Hunajpu/trabajo_terminal/README.md

# trabajo_terminal
Repositorio para llevar control de versión del trabajo terminal
