Hunajpu/trabajo_terminal/PrimerreporteparcialTrabajoTerminal/portada.tex

\begin{titlepage}
 
\begin{center}
\newcommand{\HRule}{\rule{\linewidth}{0.5mm}}

\vspace*{1cm}
 
\textsc{\LARGE Unidad Profesional Interdisciplinaria en Ingeniería y Tecnologías Avanzadas}\\[1.5cm]
 
\textsc{\Large Primer Reporte Parcial}\\[0.5cm]

\HRule \\[0.4cm]
{ \huge \bfseries Eje Lineal para Robots Colaborativos Ligeros en ROS}\\[0.4cm]
 
\HRule \\[1.5cm]

\begin{minipage}{0.4\textwidth}
\begin{flushleft} \large
\emph{Presenta:}\\
Rodrigo Luna Reyes\\
\end{flushleft}
\end{minipage}
\begin{minipage}{0.5\textwidth}
\begin{flushright} \large
\emph{Asesores:} \\
Gaston Hugo Salazar Silva
\end{flushright}
\end{minipage}
 
\vfill
 
{\large \today}
 
\end{center}
 
\end{titlepage}
