Hunajpu/trabajo_terminal/PrimerreporteparcialTrabajoTerminal/1 Inicial/Antecedentes.tex

\section{Antecedentes}
\begin{center}
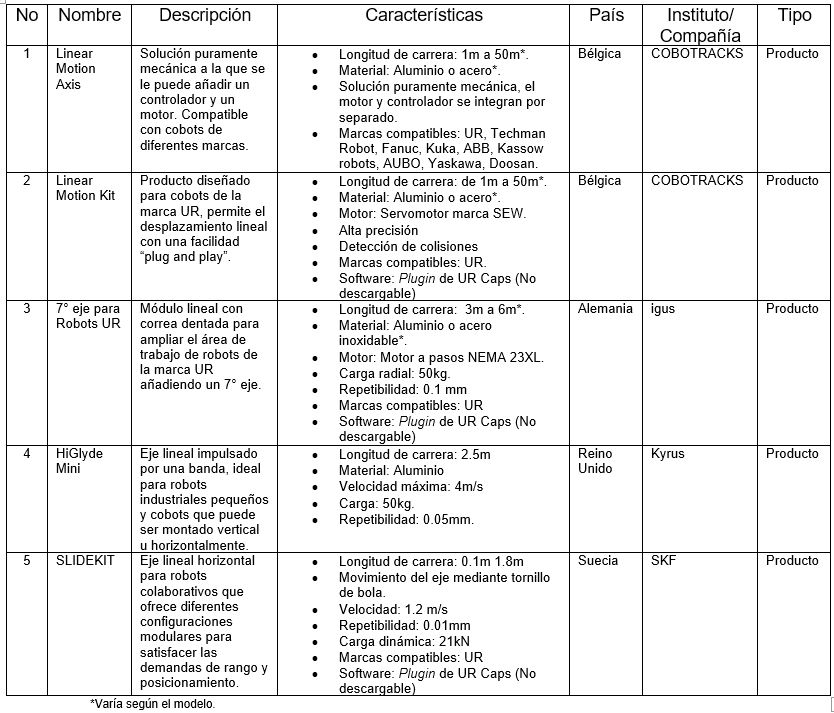
[picture p8: PrimerreporteparcialTrabajoTerminal/Tablas/tabla_antecedentes.JPG]
  
  \captionof{table}{Antecedentes}
  \label{fig:antecedentes}
\end{center}
