Hunajpu/trabajo_terminal/PrimerreporteparcialTrabajoTerminal/1 Inicial/Objetivos.tex

\section{Objetivos}
Objetivo General
\begin{itemize}
    \item Elaborar un eje lineal para diferentes modelos de robots colaborativos ligeros controlado en el entorno de código abierto “ROS”.
\end{itemize}
\begin{enumerate}
    \item Objetivos Específicos para Trabajo Terminal 1
\begin{itemize}
    \item Diseñar un mecanismo de movimiento lineal capaz de desplazar 20kg de carga.
    \item Diseñar un sistema de control para el mecanismo de movimiento.
    \item Diseñar una base compatible con diferentes modelos de cobots.
\end{itemize}

\item Objetivos Específicos para Trabajo Terminal 2
\begin{itemize}
    \item Construir el mecanismo de movimiento lineal.
    \item Construir base adaptable.
    \item Implementar el sistema de control.
    \item Codificar un paquete de ROS para la interfaz entre el eje lineal y el entorno de programación.
    \item Validar mediante simulaciones la sincronización del eje lineal y el cobot durante el seguimiento de trayectorias.
\end{itemize}

\end{enumerate}
