Hunajpu/trabajo_terminal/Cronograma/Overview.html

Project Overview

The project is structured into 3 phases.

Specification

Testing

Original Project Plan

No.

Actividad

Responsable

Inicio

Termino

Días

Jan 2022

Feb 2022

Mar 2022

Apr 2022

May 2022

Jun 2022

Jul 2022

Aug 2022

Sep 2022

Oct 2022

24

31

07

14

21

28

07

14

21

28

04

11

18

25

02

09

16

23

30

06

13

20

27

04

11

18

25

01

08

15

22

29

05

12

19

26

03

10

17

Start: 31-01-2022 End: 14-10-2022

Resources:

Precursors:

Followers:

Start: 31-01-2022 End: 06-05-2022

Resources:

Precursors:

Followers:

Construcción de subsistemas (EjeCobots.build) ]->[ 16-05-2022, Construcción de la estructura (EjeCobots.build.b_struct) ]->[ 01-08-2022, Construcción del mecanismo de movimiento (EjeCobots.build.b_mech) ]->[ 11-07-2022, Construcción de sistemas electrónicos (EjeCobots.build.b_electro) ]->[ 15-08-2022, Programación de paquete de ROS (EjeCobots.build.dev_ros) ]->[ 16-05-2022, Modelo 3D del proyecto (EjeCobots.check.sim) ]->[ 05-09-2022, Informe de TT1 (EjeCobots.doc1) ]->[ 09-05-2022

Start: 31-01-2022 End: 25-02-2022

Resources:

Rodrigo Luna Reyes (inge)

Precursors:

Followers:

Selección de motor y controladores (EjeCobots.design.motor) ]->[ 28-02-2022

Start: 28-02-2022 End: 01-03-2022

Resources:

Rodrigo Luna Reyes (inge)

Precursors:

Diseño del mecanismo de movimiento (EjeCobots.design.mech) ]->[ 25-02-2022

Followers:

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

Followers:

Start: 03-10-2022 End: 07-10-2022

Resources:

Rodrigo Luna Reyes (inge)

Precursors:

Construcción del mecanismo de movimiento (EjeCobots.build.b_mech) ]->[ 29-07-2022, Construcción de sistemas electrónicos (EjeCobots.build.b_electro) ]->[ 02-09-2022, Programación de paquete de ROS (EjeCobots.build.dev_ros) ]->[ 08-07-2022

Followers:

Start: 10-10-2022 End: 14-10-2022

Resources:

Rodrigo Luna Reyes (inge)

Precursors:

Informe de TT1 (EjeCobots.doc1) ]->[ 13-05-2022

Followers:

1

Icon | Eje lineal para Robots Colavorativos en ROS

ID: EjeCobots

Rodrigo Luna Reyes

31-01-2022

14-10-2022

185.0

1.1

| Icon | Diseño detallado

ID: EjeCobots.design

Rodrigo Luna Reyes

31-01-2022

06-05-2022

70.0

1.1.1

| Icon | Diseño del mecanismo de movimiento

ID: EjeCobots.design.mech

Rodrigo Luna Reyes

31-01-2022

25-02-2022

20.0

1.1.2

| Icon | Selección de motor y controladores

ID: EjeCobots.design.motor

Rodrigo Luna Reyes

28-02-2022

01-03-2022

2.0

1.1.3

| Icon | Diseño de la estructrua

ID: EjeCobots.design.estructura

Rodrigo Luna Reyes

02-03-2022

22-03-2022

15.0

1.1.4

| Icon | Diseño de electrónica para accionamiento mecánico

ID: EjeCobots.design.mech_electro

Rodrigo Luna Reyes

23-03-2022

07-04-2022

12.0

1.1.5

| Icon | Diseño de electrónica para gestión de información

ID: EjeCobots.design.info_electro

Rodrigo Luna Reyes

08-04-2022

25-04-2022

12.0

1.1.6

| Icon | Selección y diseño de la fuente de alimentación

ID: EjeCobots.design.psu

Rodrigo Luna Reyes

26-04-2022

27-04-2022

2.0

1.1.7

| Icon | Diseño de software

ID: EjeCobots.design.soft

Rodrigo Luna Reyes

28-04-2022

06-05-2022

7.0

1.5

| Icon | Informe de TT1

ID: EjeCobots.doc1

Rodrigo Luna Reyes

09-05-2022

13-05-2022

5.0

1.2

| Icon | Construcción de subsistemas

ID: EjeCobots.build

Rodrigo Luna Reyes

16-05-2022

02-09-2022

80.0

1.2.4

| Icon | Programación de paquete de ROS

ID: EjeCobots.build.dev_ros

Rodrigo Luna Reyes

16-05-2022

08-07-2022

40.0

1.2.2

| Icon | Construcción del mecanismo de movimiento

ID: EjeCobots.build.b_mech

Rodrigo Luna Reyes

11-07-2022

29-07-2022

15.0

1.2.1

| Icon | Construcción de la estructura

ID: EjeCobots.build.b_struct

Rodrigo Luna Reyes

01-08-2022

12-08-2022

10.0

1.2.3

| Icon | Construcción de sistemas electrónicos

ID: EjeCobots.build.b_electro

Rodrigo Luna Reyes

15-08-2022

02-09-2022

15.0

1.3

| Icon | Implementación de subsistemas

ID: EjeCobots.check

Rodrigo Luna Reyes

05-09-2022

23-09-2022

15.0

1.3.2

| Icon | Modelo 3D del proyecto

ID: EjeCobots.check.sim

Rodrigo Luna Reyes

05-09-2022

16-09-2022

10.0

1.3.1

| Icon | Ensamble de subsistemas

ID: EjeCobots.check.ensam

Rodrigo Luna Reyes

19-09-2022

23-09-2022

5.0

1.4

| Icon | Pruebas de funcionamiento

ID: EjeCobots.test

Rodrigo Luna Reyes

26-09-2022

07-10-2022

10.0

1.4.1

| Icon | Prueba de movimiento

ID: EjeCobots.test.test_mov

Rodrigo Luna Reyes

26-09-2022

30-09-2022

5.0

1.4.2

| Icon | Prueba de ROS

ID: EjeCobots.test.test_ros

Rodrigo Luna Reyes

03-10-2022

07-10-2022

5.0

1.6

| Icon | Informe de TT2

ID: EjeCobots.doc2

Rodrigo Luna Reyes

10-10-2022

14-10-2022

5.0

| | Container Task | | | Normal Task | | | Milestone
| | Off-duty period

## Staffing

All project phases are properly staffed. See ResourceGraph for detailed resource allocations.

## Current Status

The project started off with a delay of 4 days. This slightly affected the original schedule. See Deliveries for the impact on the delivery dates.

Project: Eje lineal para Cobots Version: 1.0 - Created on 2021-10-18 11:16:27 with TaskJuggler (http://www.taskjuggler.org) v3.7.1
