Hunajpu/trabajo_terminal/Base Cobots con barrenos indicados.odp

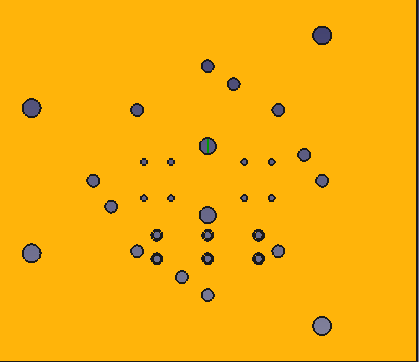
[picture p17: figure]

UR3

xArm

AUBO i3

Jaco

Bloque

Placa

Panda
