Hunajpu/trabajo_terminal/Piezas/mgn12-rail-500mm/123.PNG

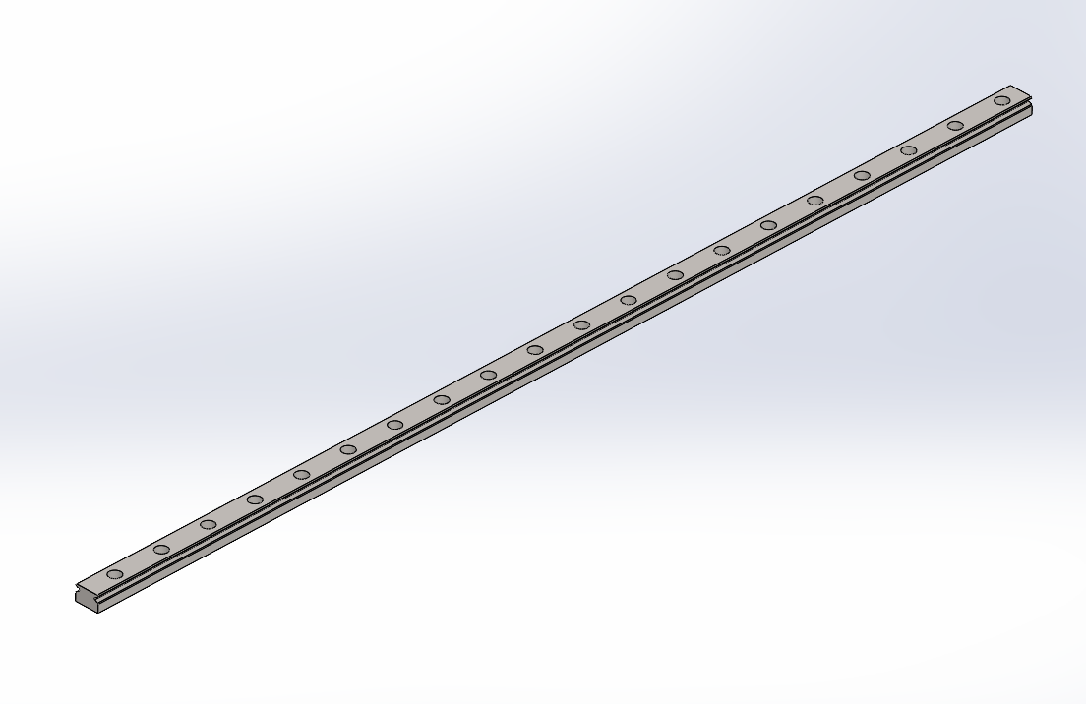
Piezas/mgn12-rail-500mm/123.PNG
