Hunajpu/trabajo_terminal/Piezas/mgn12c/MG12C.JPG

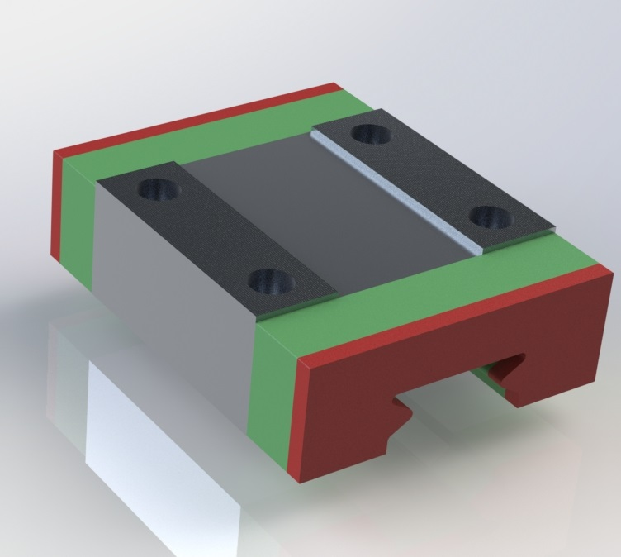
Piezas/mgn12c/MG12C.JPG
