Hunajpu/trabajo_terminal/Ensamble/Carro.FCStd

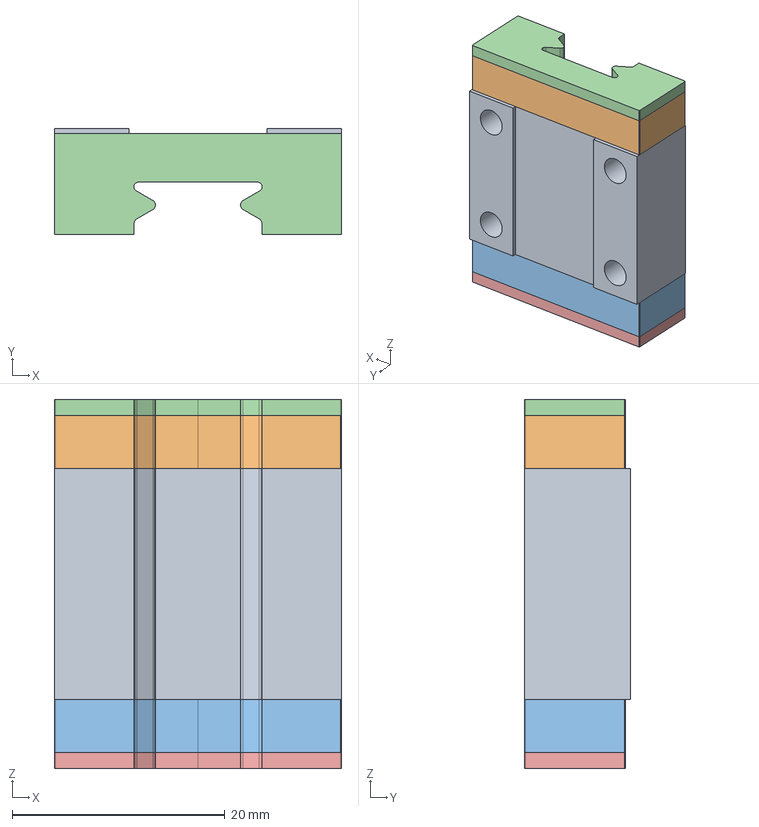
[picture p22: CAD file, 2022-05-12]
Ensamble/Carro.FCStd
27.0 x 10.0 x 34.7 mm
