Hunajpu/trabajo_terminal/Piezas/belt_clamp/TBCK-XL025.stp

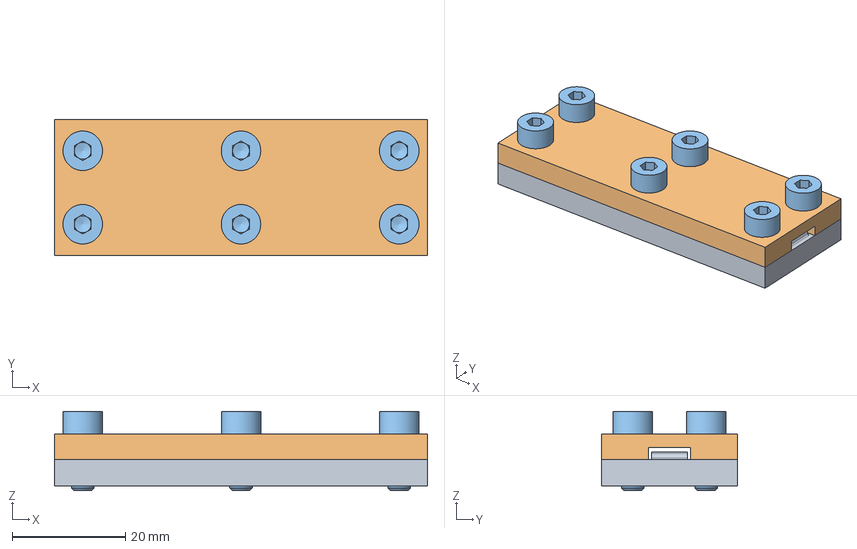
[picture p23: CAD file, 2022-05-12]
Piezas/belt_clamp/TBCK-XL025.stp
66.0 x 24.0 x 14.0 mm
_TBCKsupport_plate-XL025_r
_TBCKsupport_plate-XL025_support_plate
_CB4-10_1 x 6
