Hunajpu/trabajo_terminal/Piezas/guia_lineal/SRZL28-520.stp

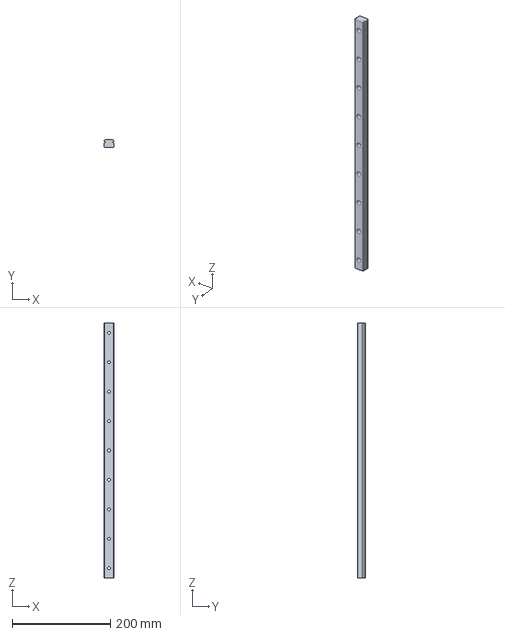
[picture p24: CAD file, 2022-03-16]
Piezas/guia_lineal/SRZL28-520.stp
20.0 x 15.5 x 520.0 mm
