Hunajpu/trabajo_terminal/Piezas/guia_lineal_set/SX2RZ28-520.stp

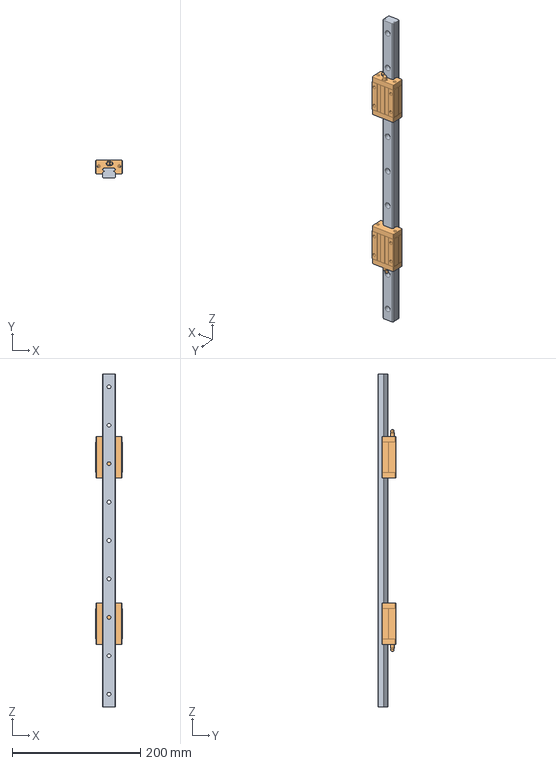
[picture p25: CAD file, 2022-03-16]
Piezas/guia_lineal_set/SX2RZ28-520.stp
42.0 x 28.0 x 520.0 mm
_SRZL28-520
_SXRB28 x 2
