Hunajpu/trabajo_terminal/Piezas/jaco.STL

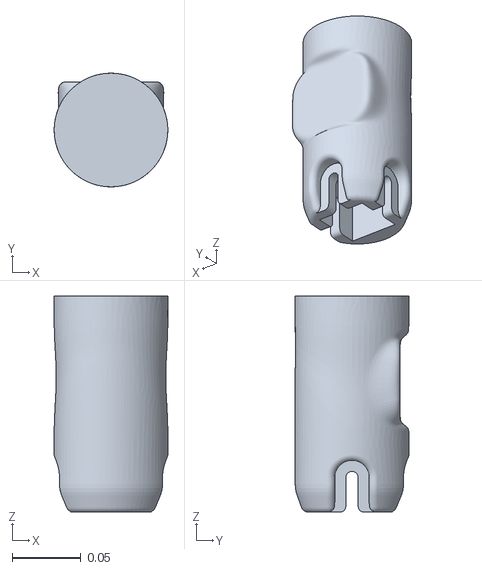
[picture p26: CAD file, 2022-03-16]
Piezas/jaco.STL
0.0825 x 0.0825 x 0.157
