Hunajpu/trabajo_terminal/Piezas/mgn12-rail-500mm/MGN12 Rail 500mm.step

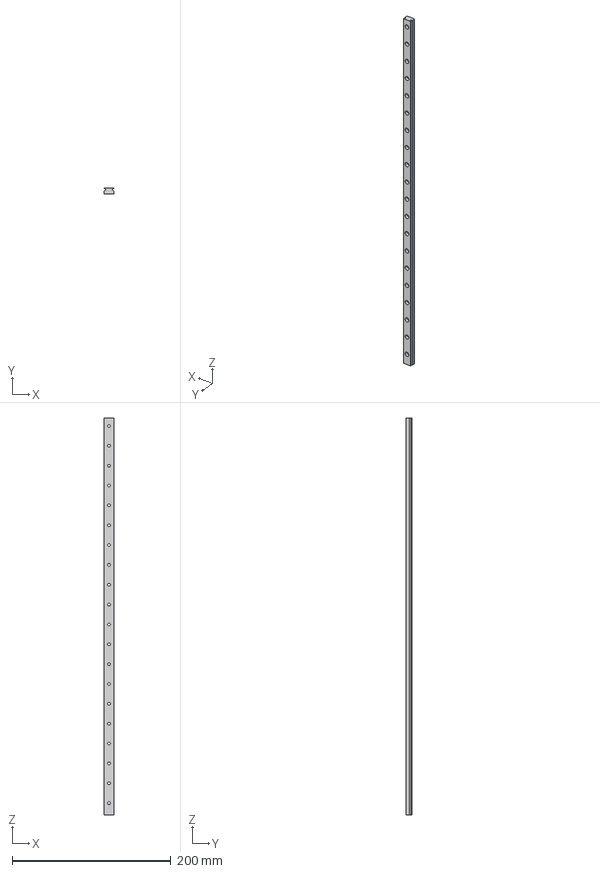
[picture p27: CAD file, 2022-03-16]
Piezas/mgn12-rail-500mm/MGN12 Rail 500mm.step
12.0 x 7.94 x 500.0 mm
