Hunajpu/trabajo_terminal/Piezas/Perfil 30x30/Aluminium30x30.step

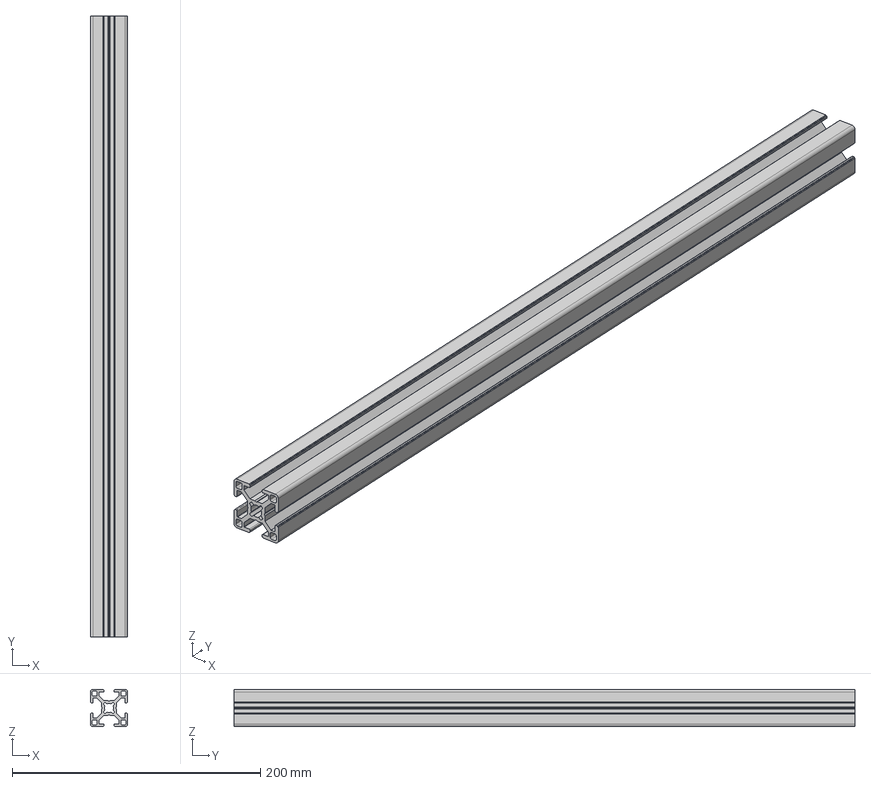
[picture p28: CAD file, 2022-05-12]
Piezas/Perfil 30x30/Aluminium30x30.step
30.0 x 500.0 x 30.0 mm
