Hunajpu/trabajo_terminal/Piezas/perfil aluminio 400/HFS8-4040-400.stp

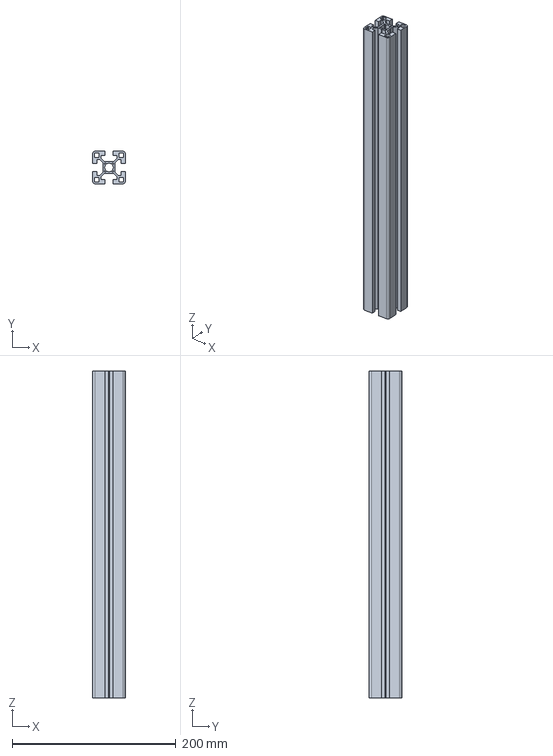
[picture p29: CAD file, 2022-03-16]
Piezas/perfil aluminio 400/HFS8-4040-400.stp
40.0 x 40.0 x 400.0 mm
