Hunajpu/trabajo_terminal/Piezas/polea/GPA15GT2090-A-H4.stp

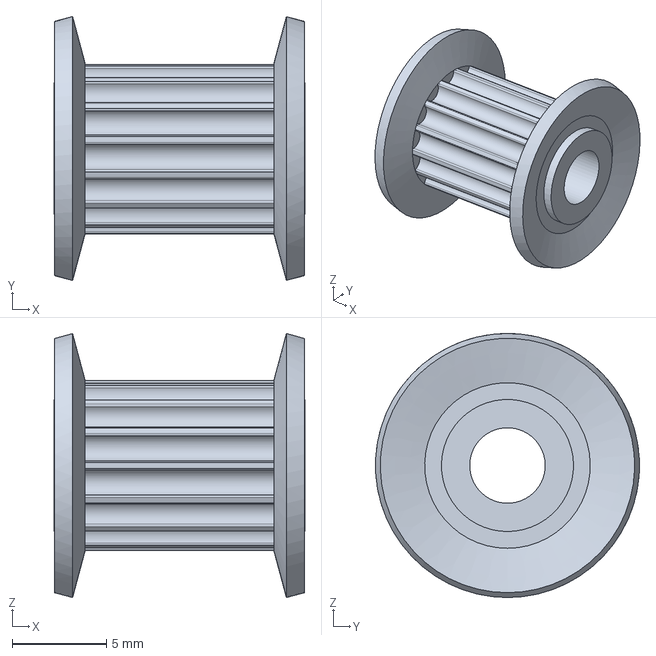
[picture p30: CAD file, 2022-03-16]
Piezas/polea/GPA15GT2090-A-H4.stp
13.3 x 14.0 x 14.0 mm
