Hunajpu/trabajo_terminal/Piezas/surpass-motor-3660-2220kv/Surpass Motor 3660 2200kv.STEP

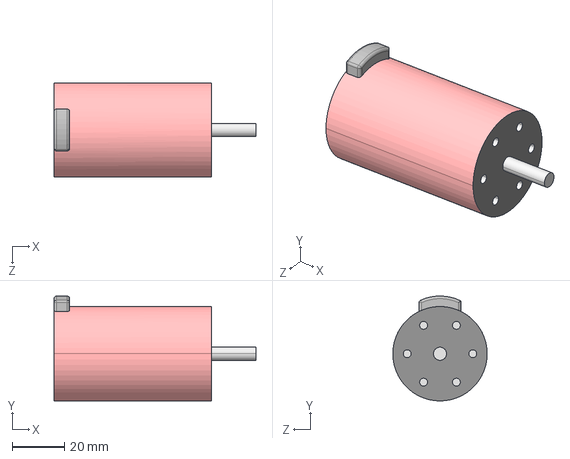
[picture p31: CAD file, 2022-03-16]
Piezas/surpass-motor-3660-2220kv/Surpass Motor 3660 2200kv.STEP
77.0 x 40.0 x 36.0 mm
