Hunajpu/trabajo_terminal/ros2_ur_driver/install/ur_description/share/ur_description/meshes/ur10/collision/wrist1.stl

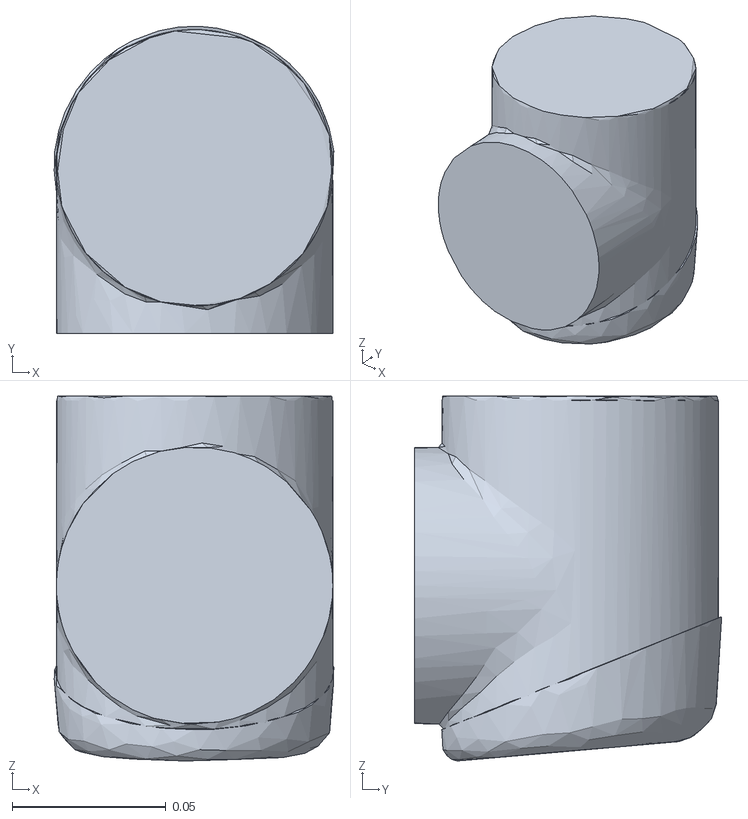
[picture p32: CAD file, 2022-03-16]
ros2_ur_driver/install/ur_description/share/ur_description/meshes/ur10/collision/wrist1.stl
0.091 x 0.1 x 0.119
