Hunajpu/trabajo_terminal/ros2_ur_driver/install/ur_description/share/ur_description/meshes/ur16e/collision/upperarm.stl

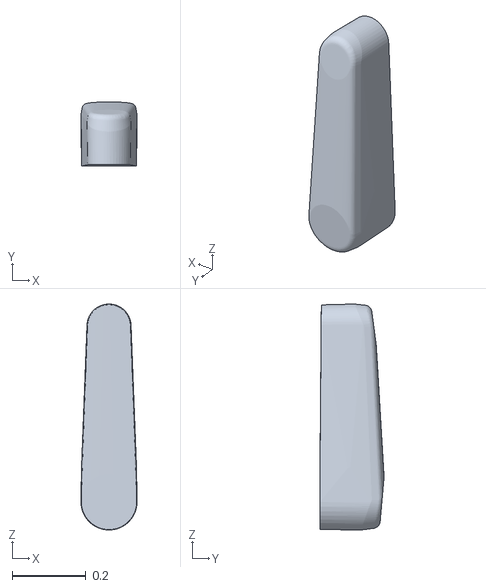
[picture p34: CAD file, 2022-03-16]
ros2_ur_driver/install/ur_description/share/ur_description/meshes/ur16e/collision/upperarm.stl
0.153 x 0.175 x 0.615
