Hunajpu/trabajo_terminal/ros2_ur_driver/install/ur_description/share/ur_description/meshes/ur3/collision/upperarm.stl

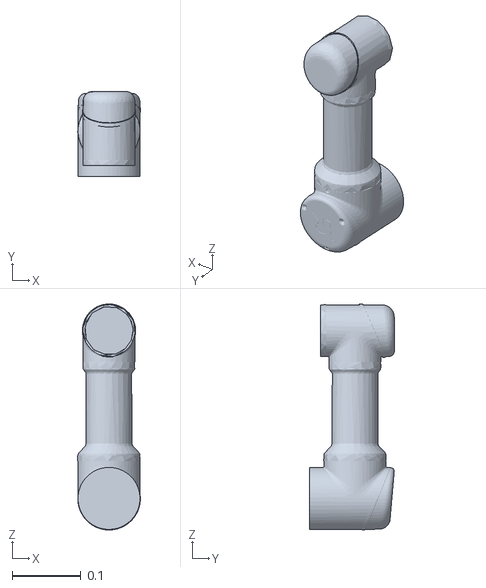
[picture p35: CAD file, 2022-03-16]
ros2_ur_driver/install/ur_description/share/ur_description/meshes/ur3/collision/upperarm.stl
0.0912 x 0.123 x 0.328
