Hunajpu/trabajo_terminal/ros2_ur_driver/install/ur_description/share/ur_description/meshes/ur3e/collision/forearm.stl

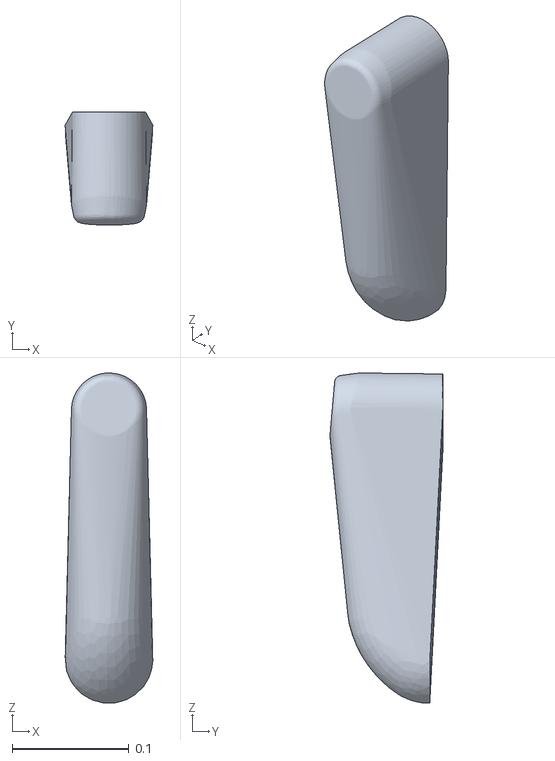
[picture p36: CAD file, 2022-03-16]
ros2_ur_driver/install/ur_description/share/ur_description/meshes/ur3e/collision/forearm.stl
0.0751 x 0.0969 x 0.283
