Hunajpu/trabajo_terminal/ros2_ur_driver/install/ur_description/share/ur_description/meshes/ur5/collision/upperarm.stl

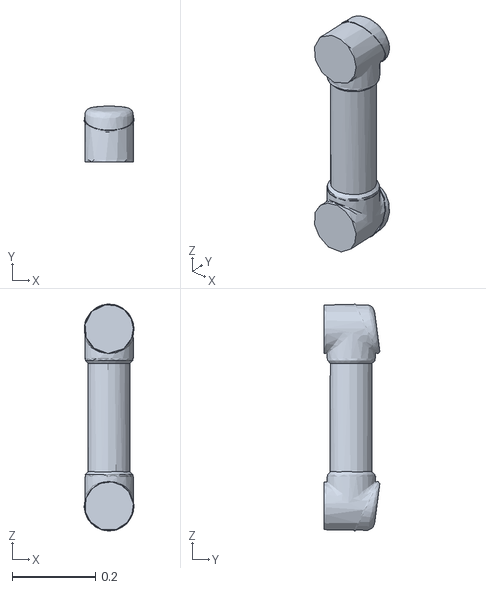
[picture p37: CAD file, 2022-03-16]
ros2_ur_driver/install/ur_description/share/ur_description/meshes/ur5/collision/upperarm.stl
0.119 x 0.134 x 0.545
