Hunajpu/trabajo_terminal/Piezas/base_link_xArm5.STL

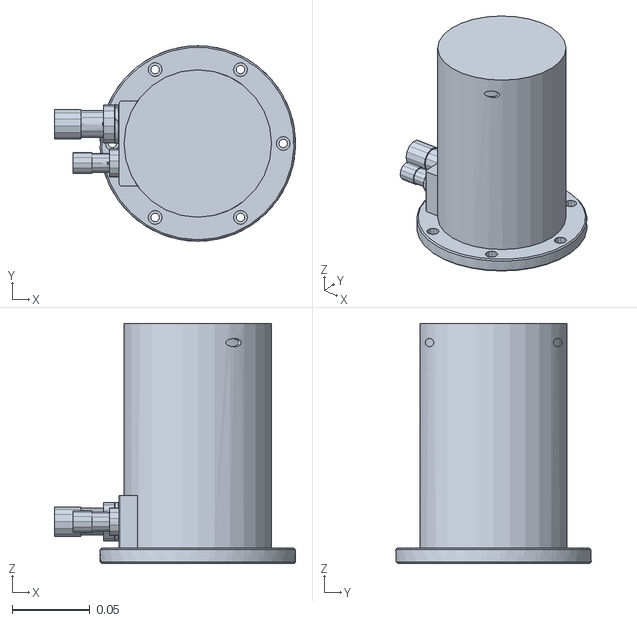
[picture p39: CAD file, 2022-03-16]
Piezas/base_link_xArm5.STL
0.155 x 0.126 x 0.155
