Hunajpu/trabajo_terminal/ros2_ur_driver/install/ur_description/share/ur_description/meshes/ur10/collision/forearm.stl

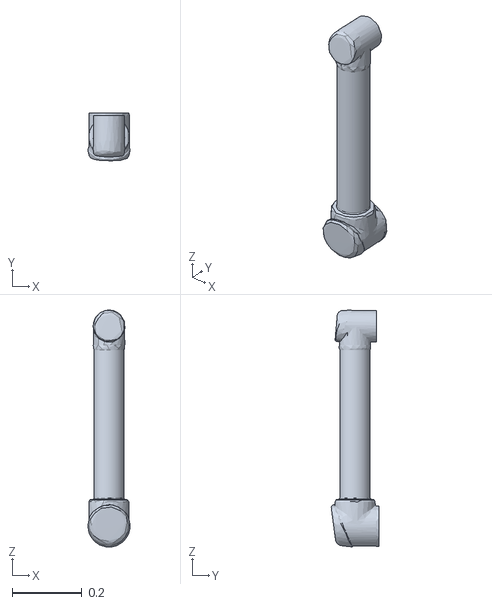
[picture p40: CAD file, 2022-03-16]
ros2_ur_driver/install/ur_description/share/ur_description/meshes/ur10/collision/forearm.stl
0.12 x 0.136 x 0.678
