Hunajpu/trabajo_terminal/ros2_ur_driver/install/ur_description/share/ur_description/meshes/ur10e/collision/wrist1.stl

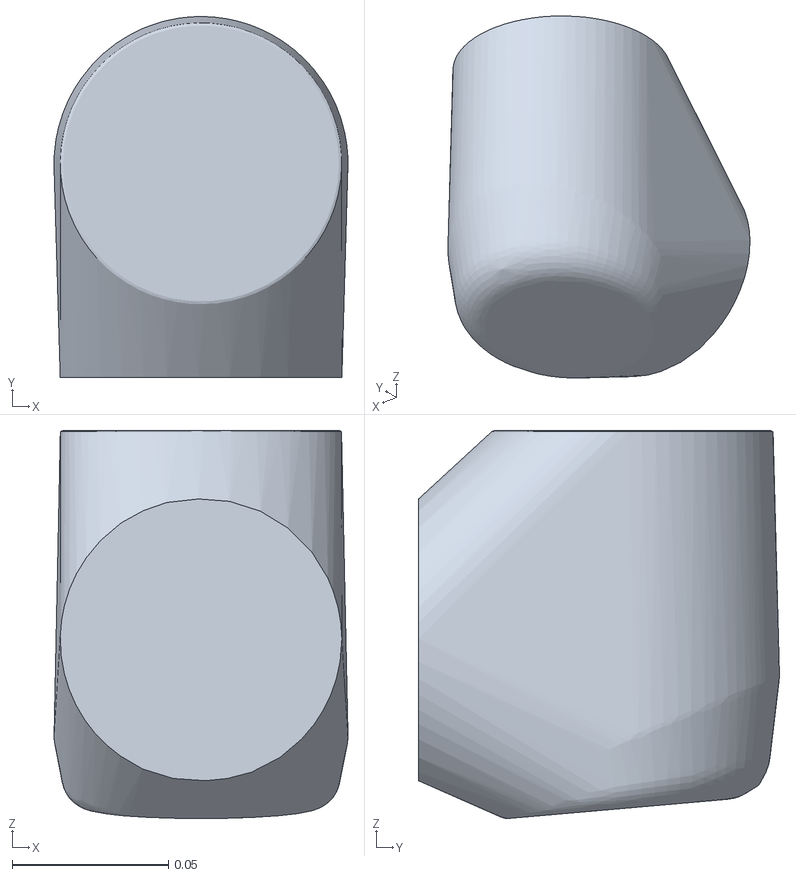
[picture p41: CAD file, 2022-03-16]
ros2_ur_driver/install/ur_description/share/ur_description/meshes/ur10e/collision/wrist1.stl
0.094 x 0.115 x 0.124
