Hunajpu/trabajo_terminal/ros2_ur_driver/install/ur_description/share/ur_description/meshes/ur3/collision/shoulder.stl

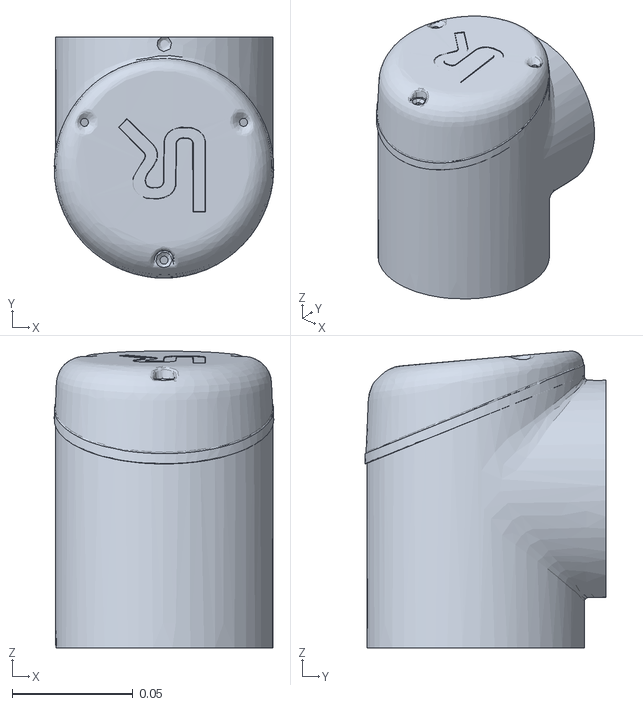
[picture p43: CAD file, 2022-03-16]
ros2_ur_driver/install/ur_description/share/ur_description/meshes/ur3/collision/shoulder.stl
0.0909 x 0.0999 x 0.123
