Hunajpu/trabajo_terminal/ros2_ur_driver/install/ur_description/share/ur_description/meshes/ur3e/collision/wrist3.stl

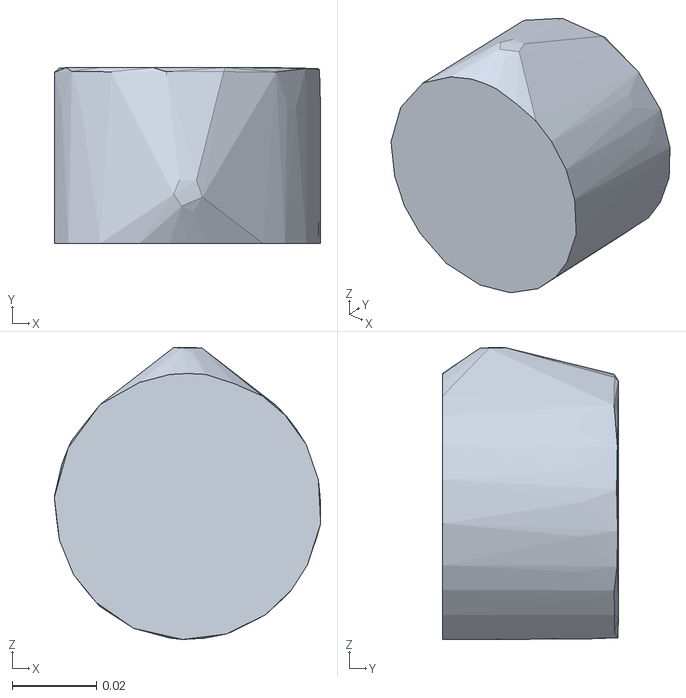
[picture p44: CAD file, 2022-03-16]
ros2_ur_driver/install/ur_description/share/ur_description/meshes/ur3e/collision/wrist3.stl
0.0632 x 0.0417 x 0.0692
