Hunajpu/trabajo_terminal/ros2_ur_driver/install/ur_description/share/ur_description/meshes/ur5/collision/wrist3.stl

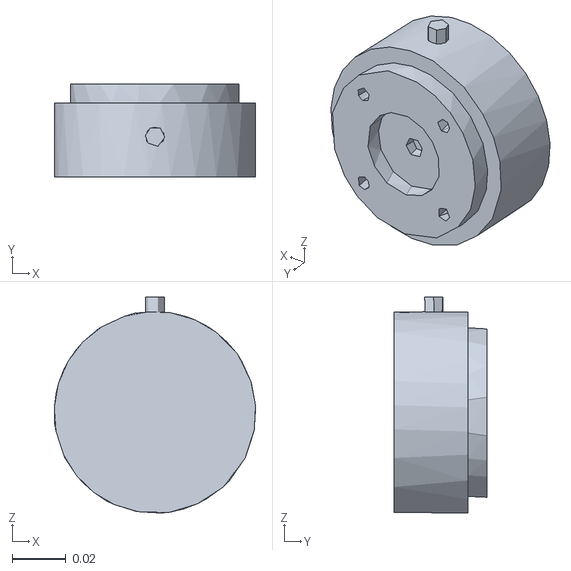
[picture p45: CAD file, 2022-03-16]
ros2_ur_driver/install/ur_description/share/ur_description/meshes/ur5/collision/wrist3.stl
0.075 x 0.0345 x 0.0805
