Hunajpu/trabajo_terminal/Ensamble/Perfil_pata.FCStd

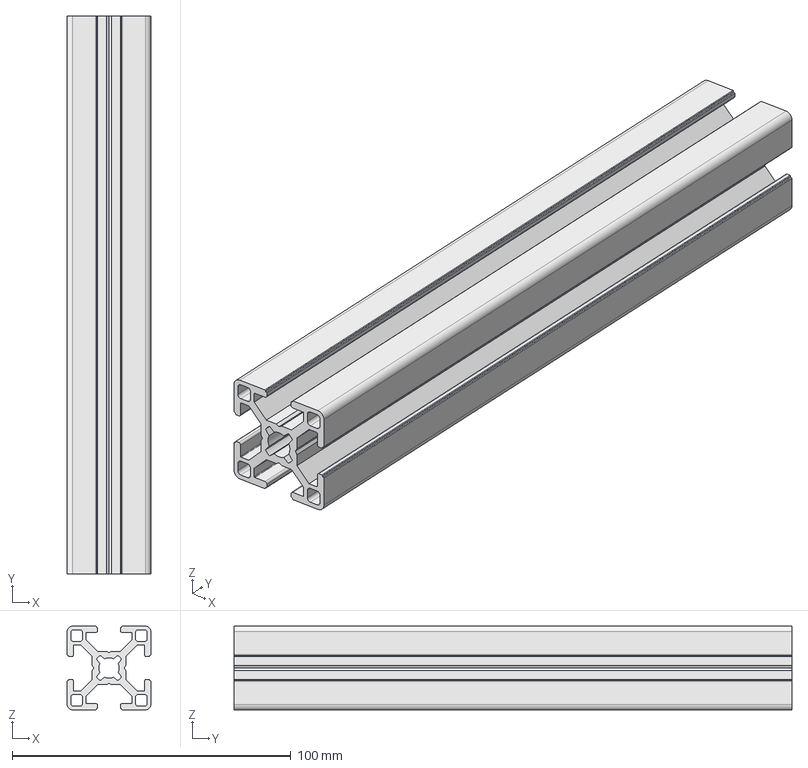
[picture p47: CAD file, 2022-05-12]
Ensamble/Perfil_pata.FCStd
30.0 x 200.0 x 30.0 mm
