Hunajpu/trabajo_terminal/Piezas/link0_frankaemika.stl

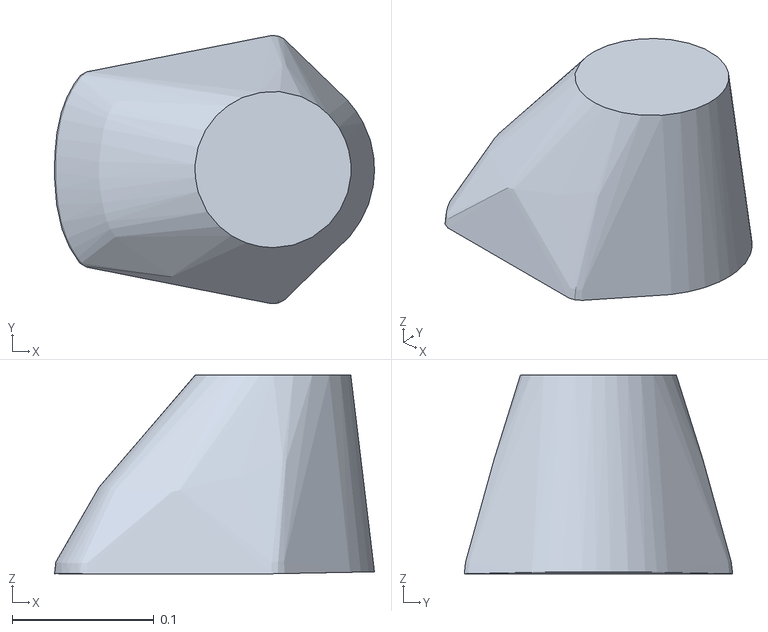
[picture p48: CAD file, 2022-03-16]
Piezas/link0_frankaemika.stl
0.226 x 0.189 x 0.14
