Hunajpu/trabajo_terminal/ros2_ur_driver/install/ur_description/share/ur_description/meshes/ur10/collision/shoulder.stl

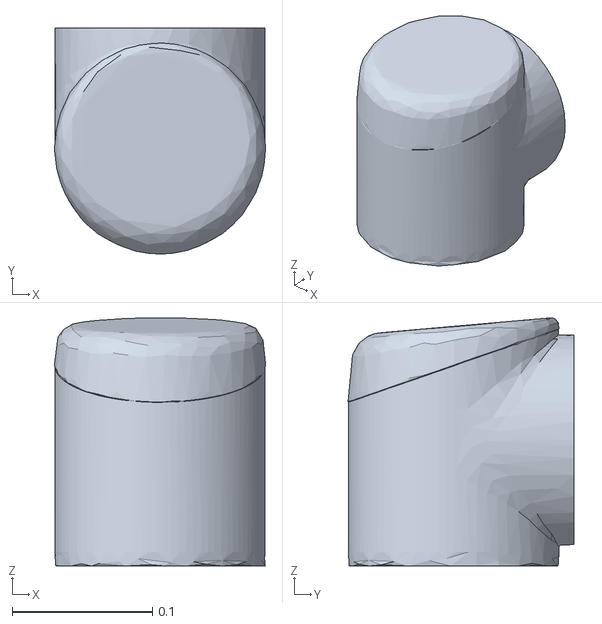
[picture p49: CAD file, 2022-03-16]
ros2_ur_driver/install/ur_description/share/ur_description/meshes/ur10/collision/shoulder.stl
0.151 x 0.161 x 0.177
