Hunajpu/trabajo_terminal/ros2_ur_driver/install/ur_description/share/ur_description/meshes/ur10e/collision/wrist3.stl

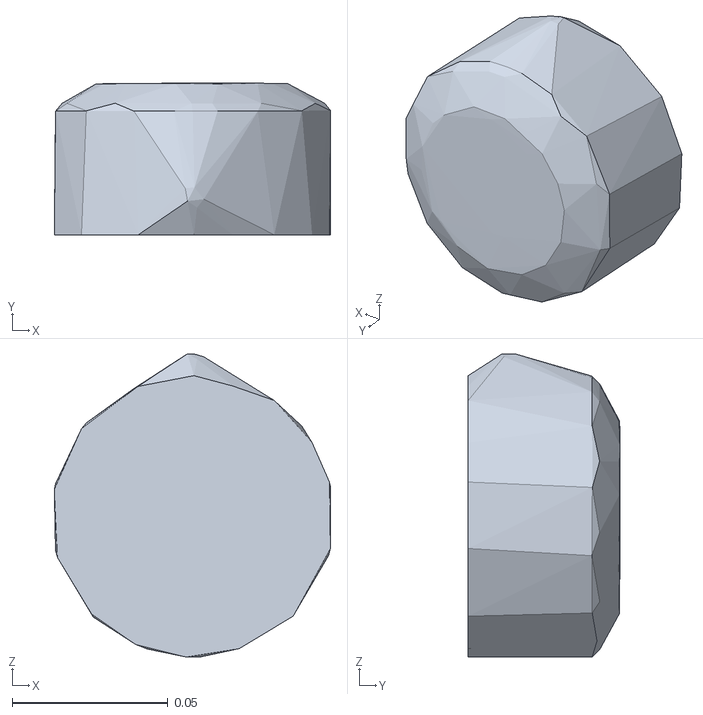
[picture p50: CAD file, 2022-03-16]
ros2_ur_driver/install/ur_description/share/ur_description/meshes/ur10e/collision/wrist3.stl
0.0888 x 0.0488 x 0.0974
