Hunajpu/trabajo_terminal/ros2_ur_driver/install/ur_description/share/ur_description/meshes/ur3e/collision/upperarm.stl

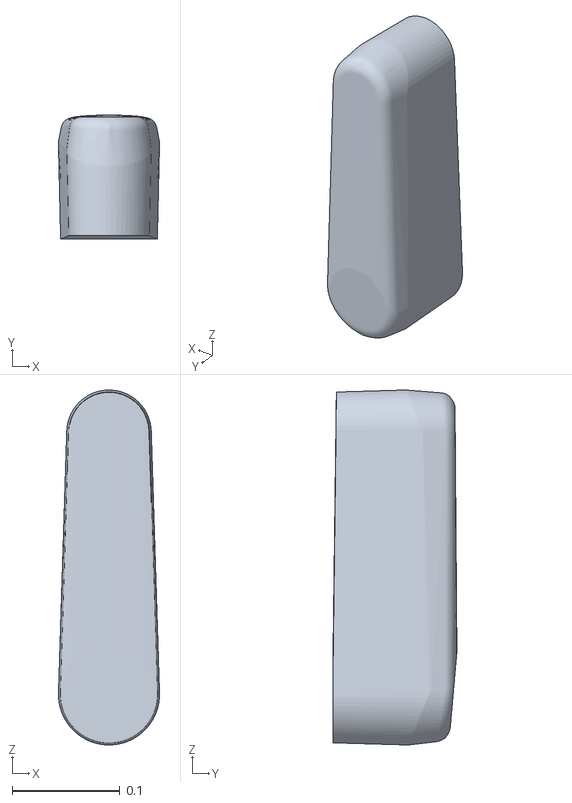
[picture p52: CAD file, 2022-03-16]
ros2_ur_driver/install/ur_description/share/ur_description/meshes/ur3e/collision/upperarm.stl
0.094 x 0.115 x 0.33
