Hunajpu/trabajo_terminal/ros2_ur_driver/install/ur_description/share/ur_description/meshes/ur5/collision/wrist1.stl

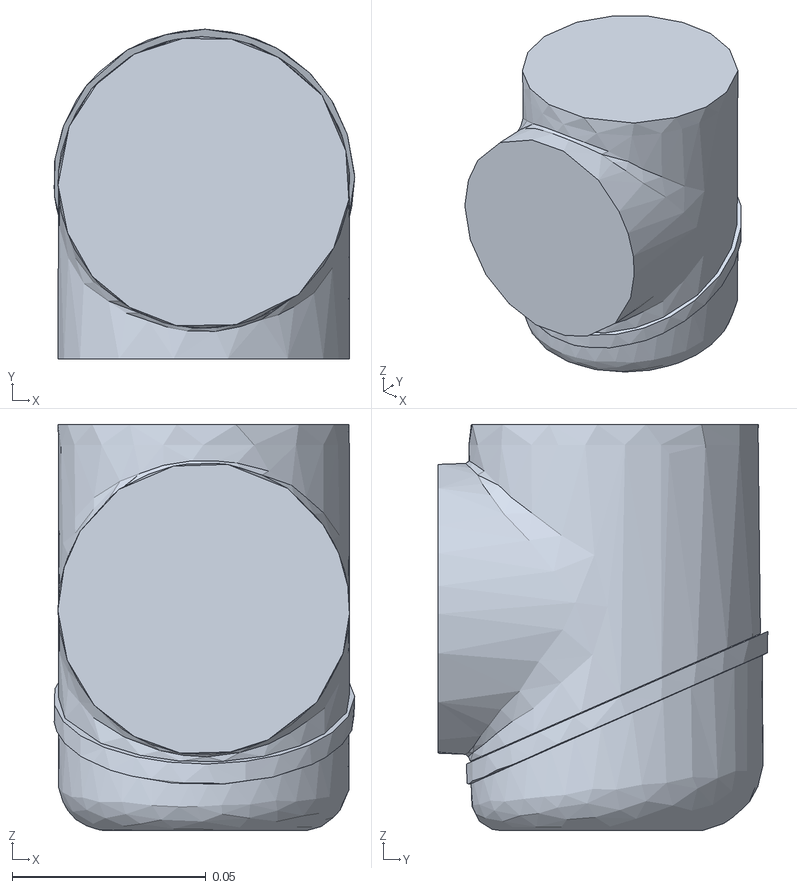
[picture p53: CAD file, 2022-03-16]
ros2_ur_driver/install/ur_description/share/ur_description/meshes/ur5/collision/wrist1.stl
0.0775 x 0.085 x 0.105
