Hunajpu/trabajo_terminal/ros2_ur_driver/install/ur_description/share/ur_description/meshes/ur5e/collision/upperarm.stl

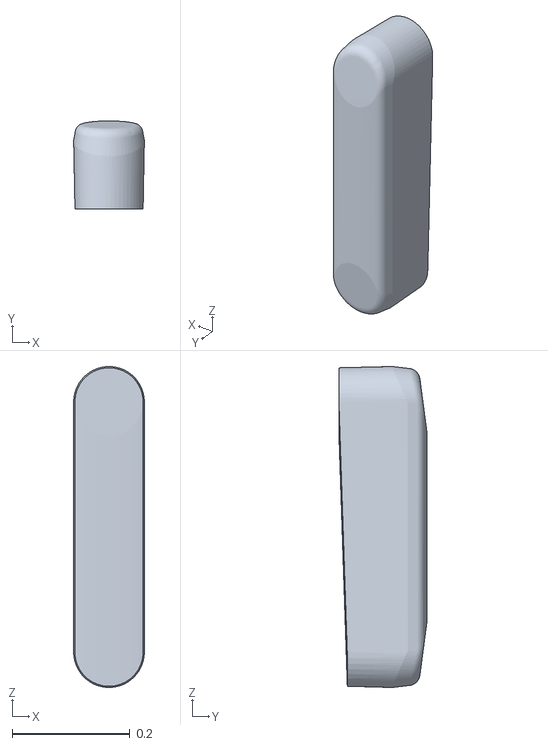
[picture p54: CAD file, 2022-03-16]
ros2_ur_driver/install/ur_description/share/ur_description/meshes/ur5e/collision/upperarm.stl
0.12 x 0.15 x 0.545
