Hunajpu/trabajo_terminal/ros2_ur_driver/install/ur_description/share/ur_description/meshes/ur10/collision/upperarm.stl

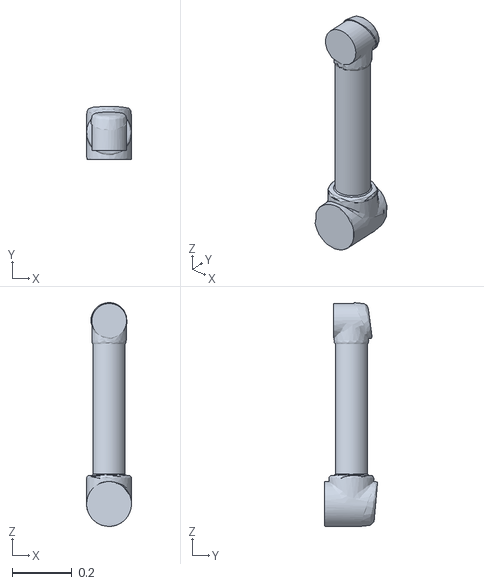
[picture p55: CAD file, 2022-03-16]
ros2_ur_driver/install/ur_description/share/ur_description/meshes/ur10/collision/upperarm.stl
0.151 x 0.177 x 0.749
