Hunajpu/trabajo_terminal/ros2_ur_driver/install/ur_description/share/ur_description/meshes/ur3e/collision/shoulder.stl

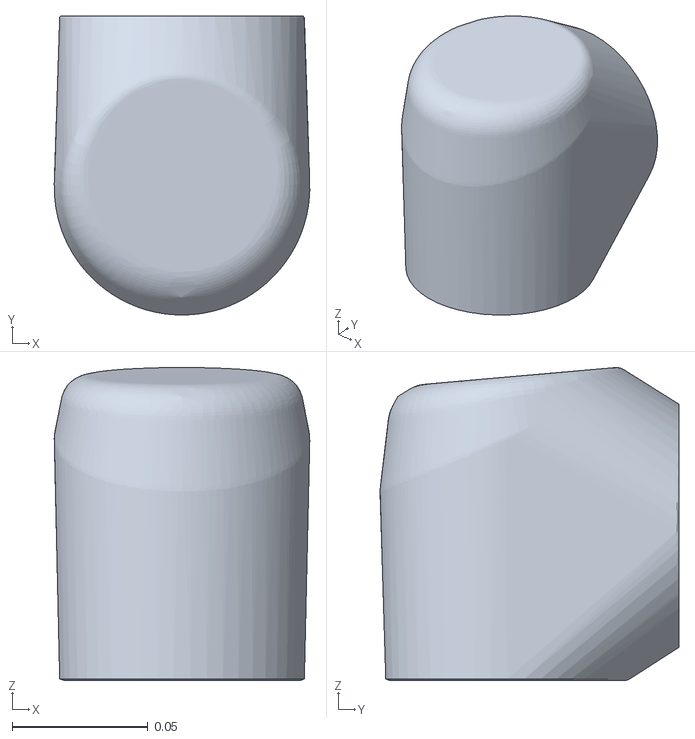
[picture p57: CAD file, 2022-03-16]
ros2_ur_driver/install/ur_description/share/ur_description/meshes/ur3e/collision/shoulder.stl
0.094 x 0.11 x 0.115
