Hunajpu/trabajo_terminal/ros2_ur_driver/install/ur_description/share/ur_description/meshes/ur5/collision/forearm.stl

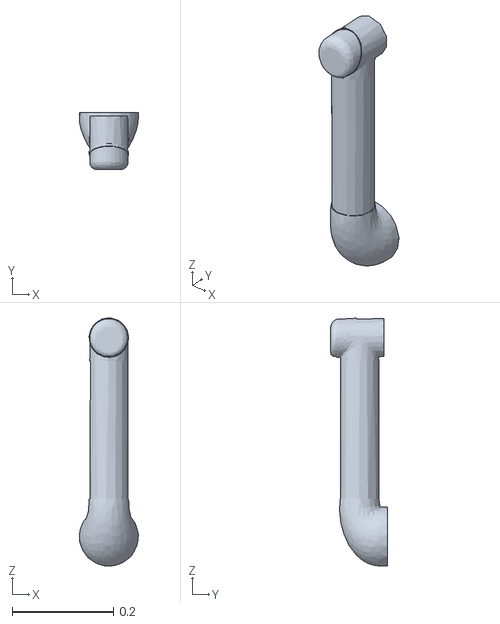
[picture p58: CAD file, 2022-03-16]
ros2_ur_driver/install/ur_description/share/ur_description/meshes/ur5/collision/forearm.stl
0.116 x 0.112 x 0.489
