Hunajpu/trabajo_terminal/ros2_ur_driver/install/ur_description/share/ur_description/meshes/ur5e/collision/wrist2.stl

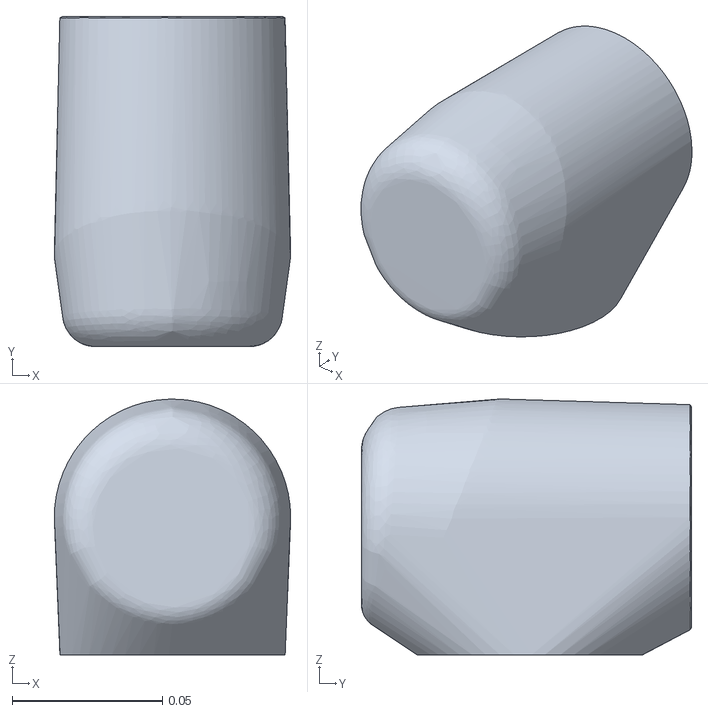
[picture p59: CAD file, 2022-03-16]
ros2_ur_driver/install/ur_description/share/ur_description/meshes/ur5e/collision/wrist2.stl
0.0787 x 0.11 x 0.0852
