Hunajpu/trabajo_terminal/Ensamble/AxisBase.FCStd

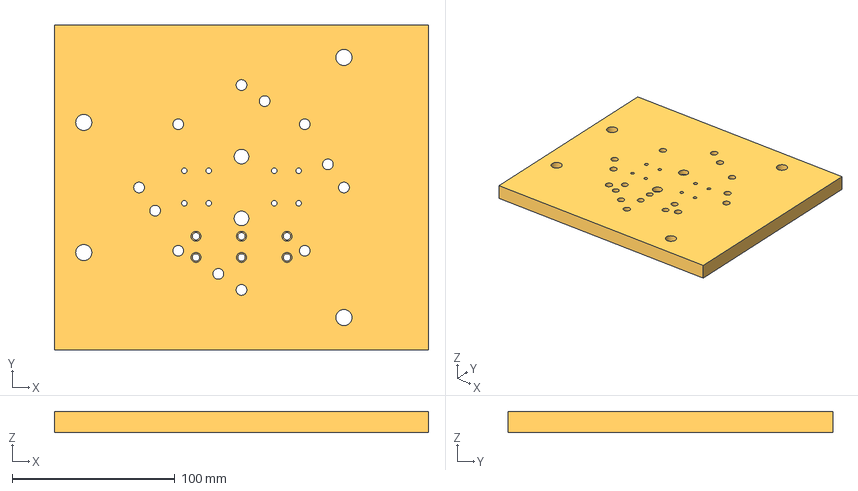
[picture p60: CAD file, 2022-05-12]
Ensamble/AxisBase.FCStd
230.0 x 200.0 x 13.0 mm
