Hunajpu/trabajo_terminal/ros2_ur_driver/install/ur_description/share/ur_description/meshes/ur10e/collision/wrist2.stl

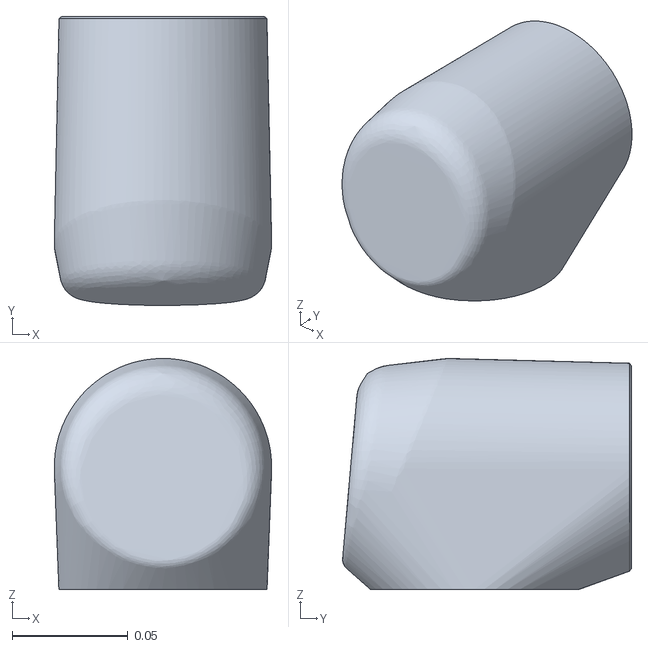
[picture p61: CAD file, 2022-03-16]
ros2_ur_driver/install/ur_description/share/ur_description/meshes/ur10e/collision/wrist2.stl
0.094 x 0.125 x 0.0999
