Hunajpu/trabajo_terminal/ros2_ur_driver/install/ur_description/share/ur_description/meshes/ur3/collision/wrist3.stl

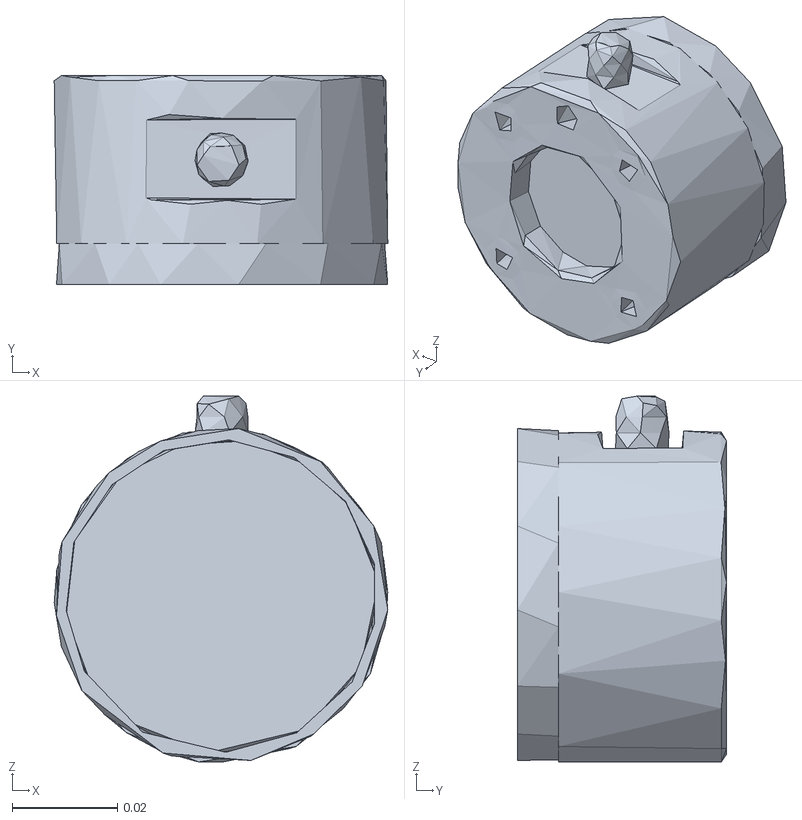
[picture p62: CAD file, 2022-03-16]
ros2_ur_driver/install/ur_description/share/ur_description/meshes/ur3/collision/wrist3.stl
0.0635 x 0.0398 x 0.0696
