Hunajpu/trabajo_terminal/ros2_ur_driver/install/ur_description/share/ur_description/meshes/ur3e/collision/wrist1.stl

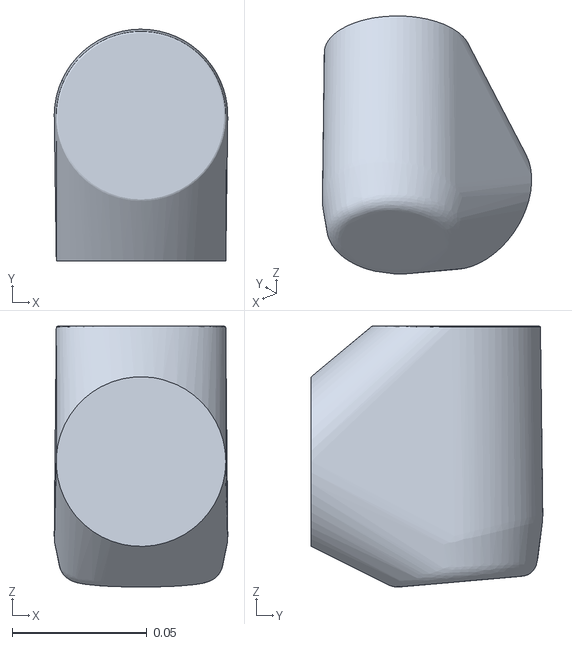
[picture p63: CAD file, 2022-03-16]
ros2_ur_driver/install/ur_description/share/ur_description/meshes/ur3e/collision/wrist1.stl
0.0645 x 0.086 x 0.0969
