Hunajpu/trabajo_terminal/ros2_ur_driver/install/ur_description/share/ur_description/meshes/ur5e/collision/wrist1.stl

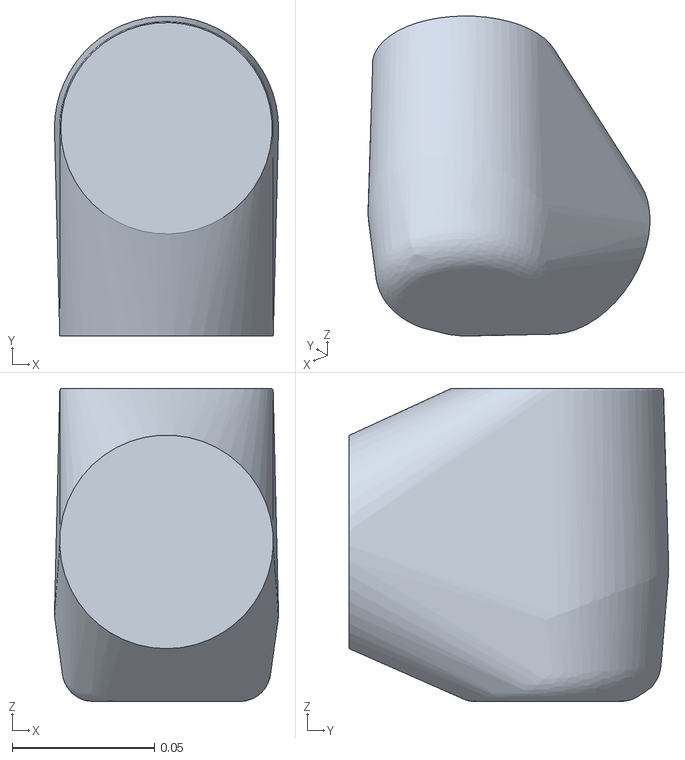
[picture p65: CAD file, 2022-03-16]
ros2_ur_driver/install/ur_description/share/ur_description/meshes/ur5e/collision/wrist1.stl
0.0787 x 0.112 x 0.11
