Hunajpu/trabajo_terminal/Ensamble/MotorSupport.FCStd

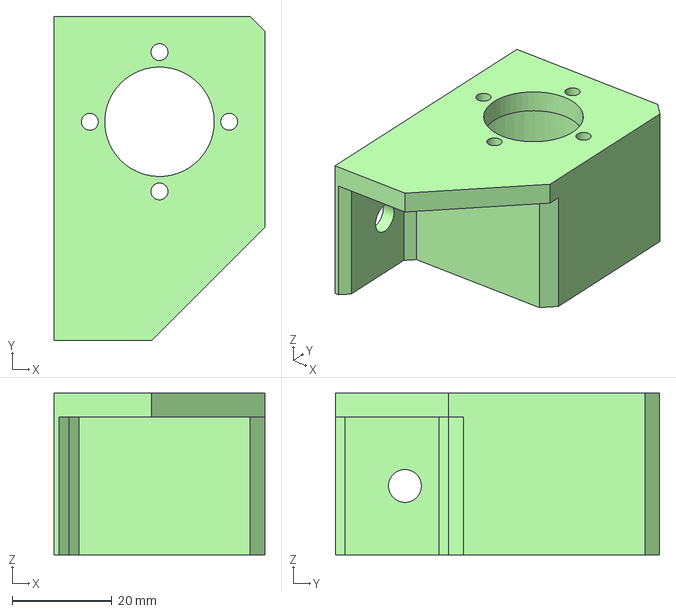
[picture p66: CAD file, 2022-05-12]
Ensamble/MotorSupport.FCStd
42.4 x 65.2 x 32.5 mm
