Hunajpu/trabajo_terminal/ros2_ur_driver/install/ur_description/share/ur_description/meshes/ur10/collision/wrist3.stl

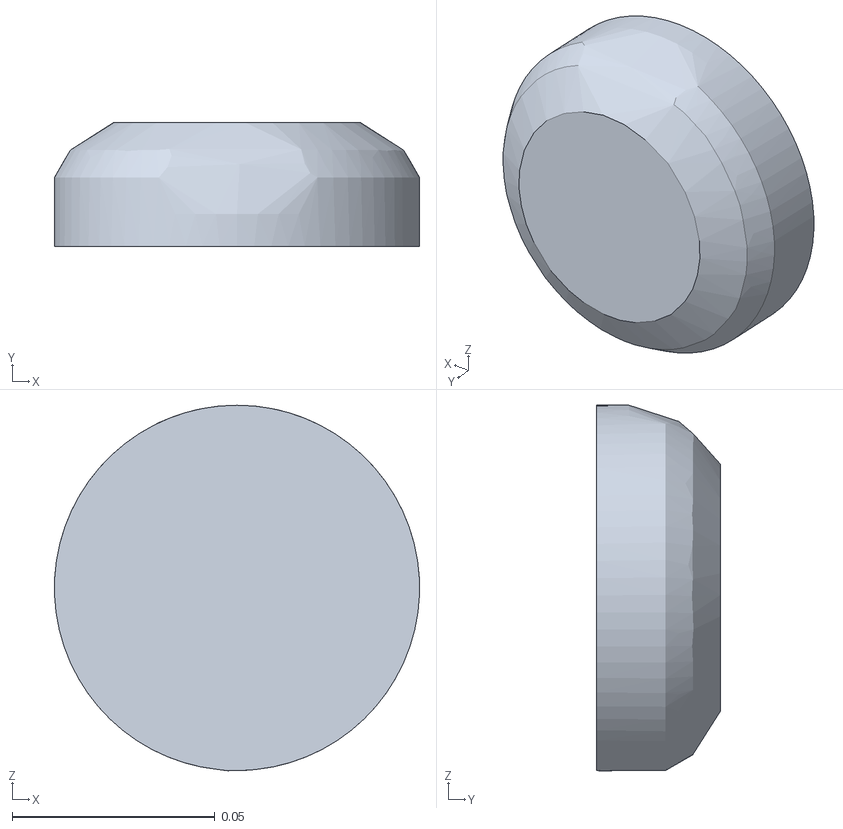
[picture p67: CAD file, 2022-03-16]
ros2_ur_driver/install/ur_description/share/ur_description/meshes/ur10/collision/wrist3.stl
0.0899 x 0.0305 x 0.0901
