Hunajpu/trabajo_terminal/Ensamble/GearboxSupport.FCStd

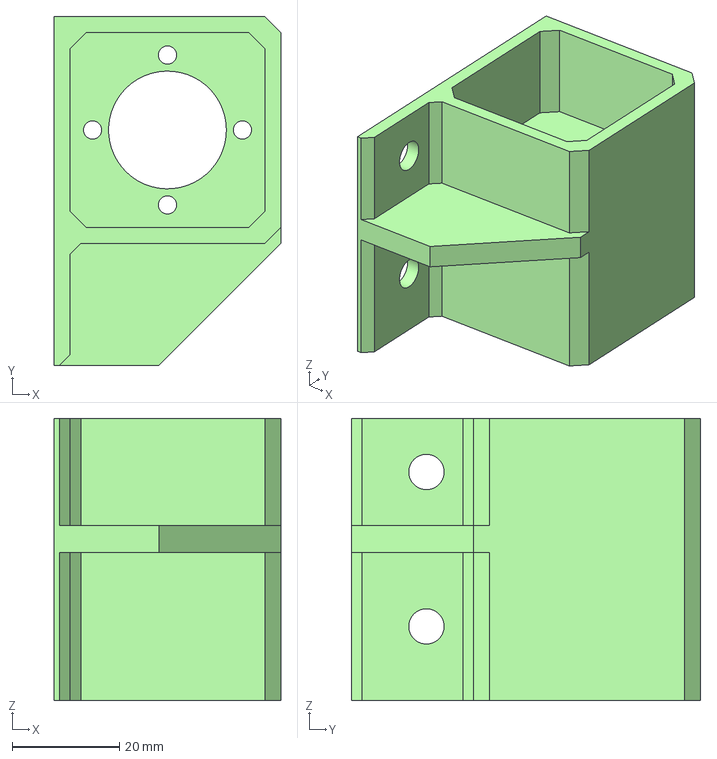
[picture p79: CAD file, 2022-05-12]
Ensamble/GearboxSupport.FCStd
42.4 x 65.2 x 52.7 mm
