Hunajpu/trabajo_terminal/Ensamble/EncoderSupport2.FCStd

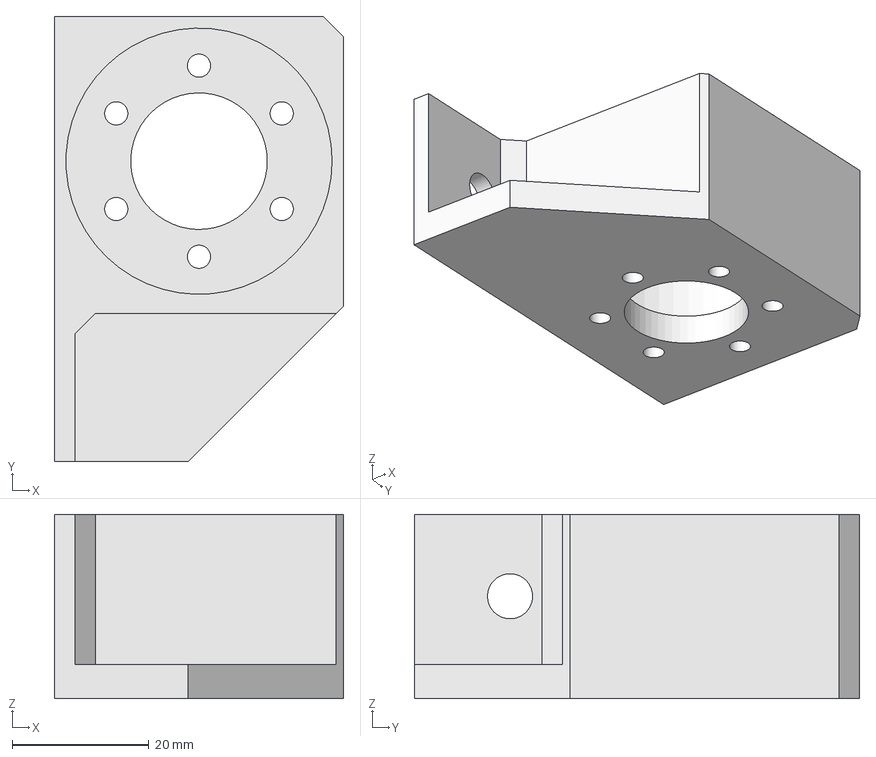
[picture p80: CAD file, 2022-05-12]
Ensamble/EncoderSupport2.FCStd
42.4 x 65.2 x 27.0 mm
