Hunajpu/trabajo_terminal/Ensamble/union_eje_6mm-8mm.FCStd

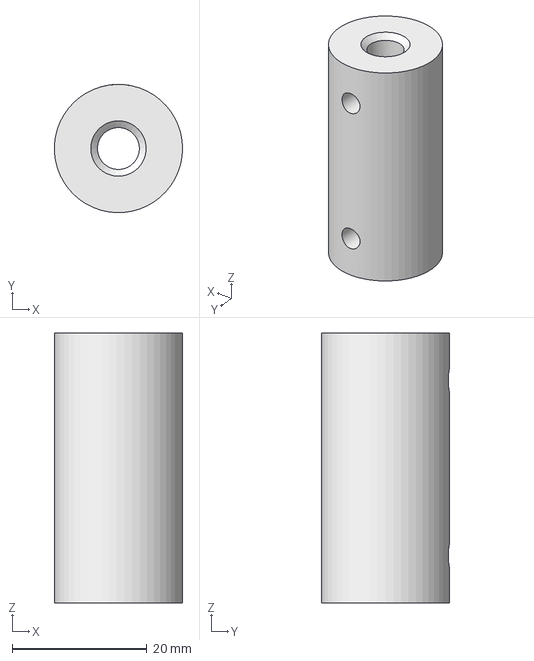
[picture p81: CAD file, 2022-05-12]
Ensamble/union_eje_6mm-8mm.FCStd
19.0 x 19.0 x 40.0 mm
