Hunajpu/trabajo_terminal/Ensamble/Correa.FCStd

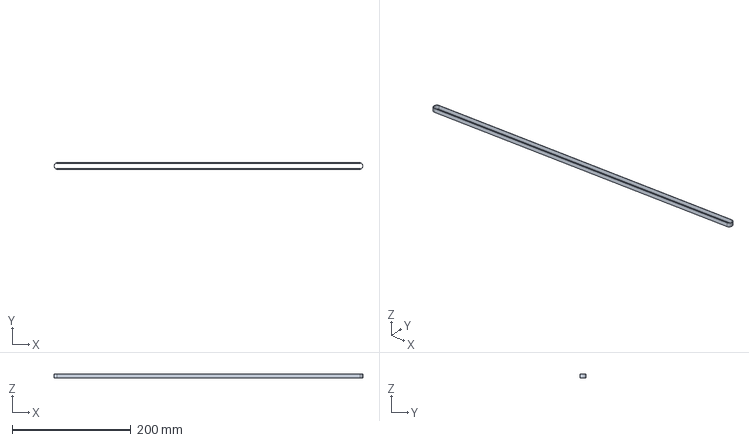
[picture p82: CAD file, 2022-05-12]
Ensamble/Correa.FCStd
520.6 x 10.6 x 6.00 mm
