Hunajpu/trabajo_terminal/Ensamble/MotorSupport2.FCStd

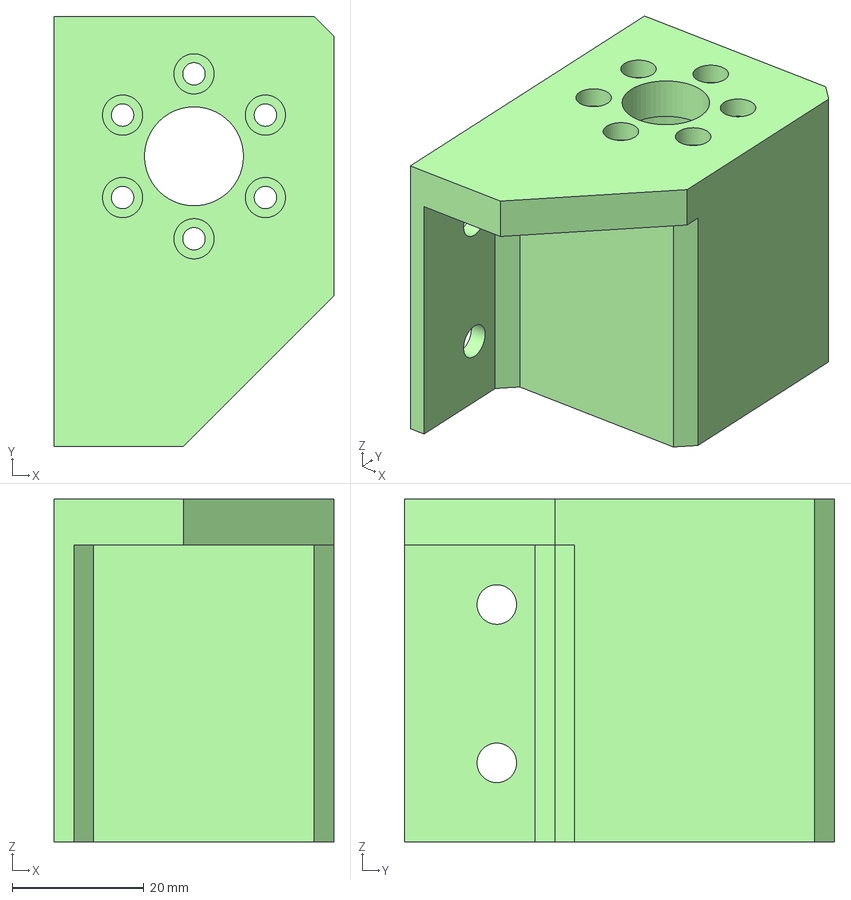
[picture p83: CAD file, 2022-05-12]
Ensamble/MotorSupport2.FCStd
42.4 x 65.2 x 52.0 mm
