Hunajpu/trabajo_terminal/Ensamble/MotorRotor.FCStd

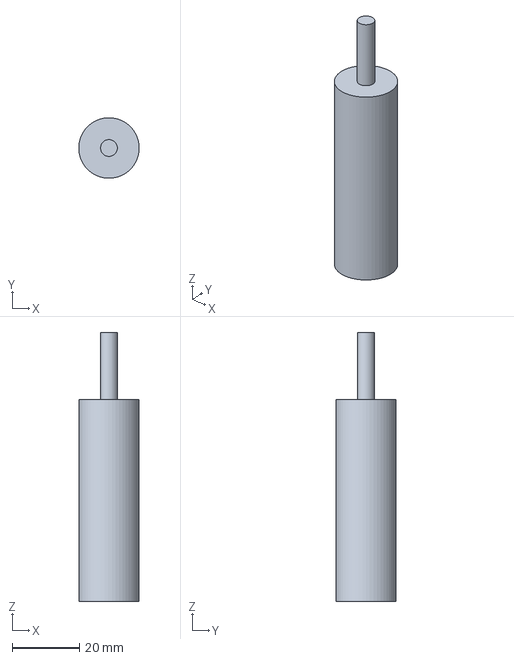
[picture p84: CAD file, 2022-05-12]
Ensamble/MotorRotor.FCStd
18.0 x 18.0 x 80.0 mm
