Hunajpu/trabajo_terminal/Ensamble/Reductor.FCStd

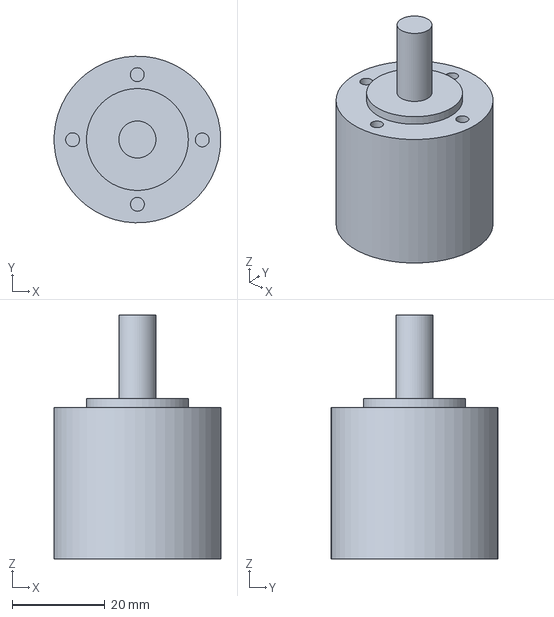
[picture p85: CAD file, 2022-05-12]
Ensamble/Reductor.FCStd
36.0 x 36.0 x 52.7 mm
