Hunajpu/trabajo_terminal/(list of files, cad)

Other CAD files:
Ensamble/Ensamble.FCStd
Piezas/mgn12c/MGN12C.step
Ensamble/Polea.FCStd
Piezas/belt_clamp/deleteThisFile.FCStd
Ensamble/Motor.FCStd
Piezas/base_xArm6.stl
ros2_ur_driver/install/ur_description/share/ur_description/meshes/ur3/collision/wrist2.stl
Piezas/base_xArm7.STL
ros2_ur_driver/install/ur_description/share/ur_description/meshes/ur10/collision/wrist2.stl
Ensamble/EjeLineal.FCStd
Ensamble/Belt_Clamp.FCStd
Ensamble/EncoderSupport.FCStd
Ensamble/Perfil_base.FCStd
Piezas/Perfil 30x30/Aluminium30x30.SLDPRT
Piezas/mgn12-rail-500mm/MGN12 Rail 500mm.SLDPRT
Piezas/mgn12c/MGN12C.SLDPRT
Piezas/sr-m4-bolt-with-nut-1.snapshot.4/SR M4 bolt nut assy.SLDPRT
Piezas/surpass-motor-3660-2220kv/Surpass Motor 3660 2200kv.SLDPRT
