Hunajpu/trabajo_terminal/ros2_ur_driver/build/control_msgs/install_manifest.txt

/home/hunajpu/trabajo_terminal/ros2_ur_driver/install/control_msgs/share/ament_index/resource_index/rosidl_interfaces/control_msgs
/home/hunajpu/trabajo_terminal/ros2_ur_driver/install/control_msgs/include/control_msgs/srv/detail/query_trajectory_state__type_support.h
/home/hunajpu/trabajo_terminal/ros2_ur_driver/install/control_msgs/include/control_msgs/srv/detail/query_trajectory_state__functions.h
/home/hunajpu/trabajo_terminal/ros2_ur_driver/install/control_msgs/include/control_msgs/srv/detail/query_calibration_state__type_support.h
/home/hunajpu/trabajo_terminal/ros2_ur_driver/install/control_msgs/include/control_msgs/srv/detail/query_calibration_state__struct.h
/home/hunajpu/trabajo_terminal/ros2_ur_driver/install/control_msgs/include/control_msgs/srv/detail/query_calibration_state__functions.h
/home/hunajpu/trabajo_terminal/ros2_ur_driver/install/control_msgs/include/control_msgs/srv/detail/query_trajectory_state__functions.c
/home/hunajpu/trabajo_terminal/ros2_ur_driver/install/control_msgs/include/control_msgs/srv/detail/query_trajectory_state__struct.h
/home/hunajpu/trabajo_terminal/ros2_ur_driver/install/control_msgs/include/control_msgs/srv/detail/query_calibration_state__functions.c
/home/hunajpu/trabajo_terminal/ros2_ur_driver/install/control_msgs/include/control_msgs/srv/query_calibration_state.h
/home/hunajpu/trabajo_terminal/ros2_ur_driver/install/control_msgs/include/control_msgs/srv/query_trajectory_state.h
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
/home/hunajpu/trabajo_terminal/ros2_ur_driver/install/control_msgs/include/control_msgs/action/detail/point_head__type_support.h
/home/hunajpu/trabajo_terminal/ros2_ur_driver/install/control_msgs/include/control_msgs/action/detail/single_joint_position__functions.h
/home/hunajpu/trabajo_terminal/ros2_ur_driver/install/control_msgs/include/control_msgs/action/detail/gripper_command__type_support.h
/home/hunajpu/trabajo_terminal/ros2_ur_driver/install/control_msgs/include/control_msgs/action/detail/follow_joint_trajectory__struct.h
/home/hunajpu/trabajo_terminal/ros2_ur_driver/install/control_msgs/include/control_msgs/action/detail/follow_joint_trajectory__functions.h
/home/hunajpu/trabajo_terminal/ros2_ur_driver/install/control_msgs/include/control_msgs/action/detail/gripper_command__struct.h
/home/hunajpu/trabajo_terminal/ros2_ur_driver/install/control_msgs/include/control_msgs/action/detail/gripper_command__functions.c
/home/hunajpu/trabajo_terminal/ros2_ur_driver/install/control_msgs/include/control_msgs/action/detail/single_joint_position__type_support.h
/home/hunajpu/trabajo_terminal/ros2_ur_driver/install/control_msgs/include/control_msgs/action/detail/joint_trajectory__struct.h
/home/hunajpu/trabajo_terminal/ros2_ur_driver/install/control_msgs/include/control_msgs/action/detail/follow_joint_trajectory__functions.c
/home/hunajpu/trabajo_terminal/ros2_ur_driver/install/control_msgs/include/control_msgs/action/detail/follow_joint_trajectory__type_support.h
/home/hunajpu/trabajo_terminal/ros2_ur_driver/install/control_msgs/include/control_msgs/action/joint_trajectory.h
/home/hunajpu/trabajo_terminal/ros2_ur_driver/install/control_msgs/include/control_msgs/action/gripper_command.h
/home/hunajpu/trabajo_terminal/ros2_ur_driver/install/control_msgs/include/control_msgs/action/single_joint_position.h
/home/hunajpu/trabajo_terminal/ros2_ur_driver/install/control_msgs/include/control_msgs/action/point_head.h
/home/hunajpu/trabajo_terminal/ros2_ur_driver/install/control_msgs/share/control_msgs/environment/library_path.sh
/home/hunajpu/trabajo_terminal/ros2_ur_driver/install/control_msgs/share/control_msgs/environment/library_path.dsv
/home/hunajpu/trabajo_terminal/ros2_ur_driver/install/control_msgs/lib/libcontrol_msgs__rosidl_generator_c.so
/home/hunajpu/trabajo_terminal/ros2_ur_driver/install/control_msgs/include/control_msgs/srv/detail/query_calibration_state__rosidl_typesupport_fastrtps_c.h
/home/hunajpu/trabajo_terminal/ros2_ur_driver/install/control_msgs/include/control_msgs/srv/detail/query_trajectory_state__rosidl_typesupport_fastrtps_c.h
/home/hunajpu/trabajo_terminal/ros2_ur_driver/install/control_msgs/include/control_msgs/msg/detail/pid_state__rosidl_typesupport_fastrtps_c.h
/home/hunajpu/trabajo_terminal/ros2_ur_driver/install/control_msgs/include/control_msgs/msg/detail/joint_jog__rosidl_typesupport_fastrtps_c.h
/home/hunajpu/trabajo_terminal/ros2_ur_driver/install/control_msgs/include/control_msgs/msg/detail/joint_trajectory_controller_state__rosidl_typesupport_fastrtps_c.h
/home/hunajpu/trabajo_terminal/ros2_ur_driver/install/control_msgs/include/control_msgs/msg/detail/gripper_command__rosidl_typesupport_fastrtps_c.h
/home/hunajpu/trabajo_terminal/ros2_ur_driver/install/control_msgs/include/control_msgs/msg/detail/joint_component_tolerance__rosidl_typesupport_fastrtps_c.h
/home/hunajpu/trabajo_terminal/ros2_ur_driver/install/control_msgs/include/control_msgs/msg/detail/interface_value__rosidl_typesupport_fastrtps_c.h
/home/hunajpu/trabajo_terminal/ros2_ur_driver/install/control_msgs/include/control_msgs/msg/detail/joint_tolerance__rosidl_typesupport_fastrtps_c.h
/home/hunajpu/trabajo_terminal/ros2_ur_driver/install/control_msgs/include/control_msgs/msg/detail/joint_controller_state__rosidl_typesupport_fastrtps_c.h
/home/hunajpu/trabajo_terminal/ros2_ur_driver/install/control_msgs/include/control_msgs/msg/detail/dynamic_joint_state__rosidl_typesupport_fastrtps_c.h
/home/hunajpu/trabajo_terminal/ros2_ur_driver/install/control_msgs/include/control_msgs/msg/rosidl_typesupport_fastrtps_c__visibility_control.h
/home/hunajpu/trabajo_terminal/ros2_ur_driver/install/control_msgs/include/control_msgs/action/detail/follow_joint_trajectory__rosidl_typesupport_fastrtps_c.h
/home/hunajpu/trabajo_terminal/ros2_ur_driver/install/control_msgs/include/control_msgs/action/detail/point_head__rosidl_typesupport_fastrtps_c.h
/home/hunajpu/trabajo_terminal/ros2_ur_driver/install/control_msgs/include/control_msgs/action/detail/gripper_command__rosidl_typesupport_fastrtps_c.h
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
/home/hunajpu/trabajo_terminal/ros2_ur_driver/install/control_msgs/lib/python3.8/site-packages/control_msgs/srv/_query_trajectory_state.py
/home/hunajpu/trabajo_terminal/ros2_ur_driver/install/control_msgs/lib/python3.8/site-packages/control_msgs/srv/_query_trajectory_state_s.c
/home/hunajpu/trabajo_terminal/ros2_ur_driver/install/control_msgs/lib/python3.8/site-packages/control_msgs/srv/_query_calibration_state_s.c
/home/hunajpu/trabajo_terminal/ros2_ur_driver/install/control_msgs/lib/python3.8/site-packages/control_msgs/action/__init__.py
/home/hunajpu/trabajo_terminal/ros2_ur_driver/install/control_msgs/lib/python3.8/site-packages/control_msgs/action/_follow_joint_trajectory_s.c
/home/hunajpu/trabajo_terminal/ros2_ur_driver/install/control_msgs/lib/python3.8/site-packages/control_msgs/action/_gripper_command.py
/home/hunajpu/trabajo_terminal/ros2_ur_driver/install/control_msgs/lib/python3.8/site-packages/control_msgs/action/_joint_trajectory.py
/home/hunajpu/trabajo_terminal/ros2_ur_driver/install/control_msgs/lib/python3.8/site-packages/control_msgs/action/_single_joint_position.py
/home/hunajpu/trabajo_terminal/ros2_ur_driver/install/control_msgs/lib/python3.8/site-packages/control_msgs/action/_single_joint_position_s.c
/home/hunajpu/trabajo_terminal/ros2_ur_driver/install/control_msgs/lib/python3.8/site-packages/control_msgs/action/_point_head_s.c
/home/hunajpu/trabajo_terminal/ros2_ur_driver/install/control_msgs/lib/python3.8/site-packages/control_msgs/action/_follow_joint_trajectory.py
/home/hunajpu/trabajo_terminal/ros2_ur_driver/install/control_msgs/lib/python3.8/site-packages/control_msgs/action/_point_head.py
/home/hunajpu/trabajo_terminal/ros2_ur_driver/install/control_msgs/lib/python3.8/site-packages/control_msgs/action/_joint_trajectory_s.c
/home/hunajpu/trabajo_terminal/ros2_ur_driver/install/control_msgs/lib/python3.8/site-packages/control_msgs/action/_gripper_command_s.c
/home/hunajpu/trabajo_terminal/ros2_ur_driver/install/control_msgs/lib/python3.8/site-packages/control_msgs/control_msgs_s__rosidl_typesupport_fastrtps_c.cpython-38-x86_64-linux-gnu.so
/home/hunajpu/trabajo_terminal/ros2_ur_driver/install/control_msgs/lib/python3.8/site-packages/control_msgs/control_msgs_s__rosidl_typesupport_introspection_c.cpython-38-x86_64-linux-gnu.so
/home/hunajpu/trabajo_terminal/ros2_ur_driver/install/control_msgs/lib/python3.8/site-packages/control_msgs/control_msgs_s__rosidl_typesupport_c.cpython-38-x86_64-linux-gnu.so
/home/hunajpu/trabajo_terminal/ros2_ur_driver/install/control_msgs/lib/libcontrol_msgs__python.so
/home/hunajpu/trabajo_terminal/ros2_ur_driver/install/control_msgs/share/control_msgs/msg/DynamicJointState.idl
/home/hunajpu/trabajo_terminal/ros2_ur_driver/install/control_msgs/share/control_msgs/msg/GripperCommand.idl
/home/hunajpu/trabajo_terminal/ros2_ur_driver/install/control_msgs/share/control_msgs/msg/InterfaceValue.idl
/home/hunajpu/trabajo_terminal/ros2_ur_driver/install/control_msgs/share/control_msgs/msg/JointComponentTolerance.idl
/home/hunajpu/trabajo_terminal/ros2_ur_driver/install/control_msgs/share/control_msgs/msg/JointControllerState.idl
/home/hunajpu/trabajo_terminal/ros2_ur_driver/install/control_msgs/share/control_msgs/msg/JointJog.idl
/home/hunajpu/trabajo_terminal/ros2_ur_driver/install/control_msgs/share/control_msgs/msg/JointTolerance.idl
/home/hunajpu/trabajo_terminal/ros2_ur_driver/install/control_msgs/share/control_msgs/msg/JointTrajectoryControllerState.idl
/home/hunajpu/trabajo_terminal/ros2_ur_driver/install/control_msgs/share/control_msgs/msg/PidState.idl
/home/hunajpu/trabajo_terminal/ros2_ur_driver/install/control_msgs/share/control_msgs/srv/QueryCalibrationState.idl
/home/hunajpu/trabajo_terminal/ros2_ur_driver/install/control_msgs/share/control_msgs/srv/QueryTrajectoryState.idl
/home/hunajpu/trabajo_terminal/ros2_ur_driver/install/control_msgs/share/control_msgs/action/FollowJointTrajectory.idl
/home/hunajpu/trabajo_terminal/ros2_ur_driver/install/control_msgs/share/control_msgs/action/GripperCommand.idl
/home/hunajpu/trabajo_terminal/ros2_ur_driver/install/control_msgs/share/control_msgs/action/JointTrajectory.idl
/home/hunajpu/trabajo_terminal/ros2_ur_driver/install/control_msgs/share/control_msgs/action/PointHead.idl
/home/hunajpu/trabajo_terminal/ros2_ur_driver/install/control_msgs/share/control_msgs/action/SingleJointPosition.idl
/home/hunajpu/trabajo_terminal/ros2_ur_driver/install/control_msgs/share/control_msgs/msg/DynamicJointState.msg
/home/hunajpu/trabajo_terminal/ros2_ur_driver/install/control_msgs/share/control_msgs/msg/GripperCommand.msg
/home/hunajpu/trabajo_terminal/ros2_ur_driver/install/control_msgs/share/control_msgs/msg/InterfaceValue.msg
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
/home/hunajpu/trabajo_terminal/ros2_ur_driver/install/control_msgs/share/control_msgs/cmake/control_msgs__rosidl_generator_cppExport.cmake
/home/hunajpu/trabajo_terminal/ros2_ur_driver/install/control_msgs/share/control_msgs/cmake/control_msgs__rosidl_typesupport_introspection_cppExport.cmake
/home/hunajpu/trabajo_terminal/ros2_ur_driver/install/control_msgs/share/control_msgs/cmake/control_msgs__rosidl_typesupport_introspection_cppExport-release.cmake
/home/hunajpu/trabajo_terminal/ros2_ur_driver/install/control_msgs/share/control_msgs/cmake/control_msgs__rosidl_typesupport_cppExport.cmake
/home/hunajpu/trabajo_terminal/ros2_ur_driver/install/control_msgs/share/control_msgs/cmake/control_msgs__rosidl_typesupport_cppExport-release.cmake
/home/hunajpu/trabajo_terminal/ros2_ur_driver/install/control_msgs/share/control_msgs/cmake/rosidl_cmake-extras.cmake
/home/hunajpu/trabajo_terminal/ros2_ur_driver/install/control_msgs/share/control_msgs/cmake/ament_cmake_export_dependencies-extras.cmake
/home/hunajpu/trabajo_terminal/ros2_ur_driver/install/control_msgs/share/control_msgs/cmake/ament_cmake_export_libraries-extras.cmake
/home/hunajpu/trabajo_terminal/ros2_ur_driver/install/control_msgs/share/control_msgs/cmake/ament_cmake_export_targets-extras.cmake
/home/hunajpu/trabajo_terminal/ros2_ur_driver/install/control_msgs/share/control_msgs/cmake/ament_cmake_export_include_directories-extras.cmake
/home/hunajpu/trabajo_terminal/ros2_ur_driver/install/control_msgs/share/control_msgs/cmake/rosidl_cmake_export_typesupport_libraries-extras.cmake
/home/hunajpu/trabajo_terminal/ros2_ur_driver/install/control_msgs/share/control_msgs/cmake/rosidl_cmake_export_typesupport_targets-extras.cmake
/home/hunajpu/trabajo_terminal/ros2_ur_driver/install/control_msgs/share/control_msgs/cmake/control_msgsConfig.cmake
/home/hunajpu/trabajo_terminal/ros2_ur_driver/install/control_msgs/share/control_msgs/cmake/control_msgsConfig-version.cmake
/home/hunajpu/trabajo_terminal/ros2_ur_driver/install/control_msgs/share/control_msgs/package.xml
