Hunajpu/trabajo_terminal/ros2_ur_driver/build/rrbot_description/install_manifest.txt

/home/hunajpu/trabajo_terminal/ros2_ur_driver/install/rrbot_description/share/rrbot_description/config/rrbot.rviz
/home/hunajpu/trabajo_terminal/ros2_ur_driver/install/rrbot_description/share/rrbot_description/gazebo/rrbot.gazebo.xacro
/home/hunajpu/trabajo_terminal/ros2_ur_driver/install/rrbot_description/share/rrbot_description/gazebo/rrbot.materials.xacro
/home/hunajpu/trabajo_terminal/ros2_ur_driver/install/rrbot_description/share/rrbot_description/meshes/hokuyo.dae
/home/hunajpu/trabajo_terminal/ros2_ur_driver/install/rrbot_description/share/rrbot_description/launch/view_robot.launch.py
/home/hunajpu/trabajo_terminal/ros2_ur_driver/install/rrbot_description/share/rrbot_description/ros2_control/external_rrbot_force_torque_sensor.ros2_control.xacro
/home/hunajpu/trabajo_terminal/ros2_ur_driver/install/rrbot_description/share/rrbot_description/ros2_control/rrbot.ros2_control.xacro
/home/hunajpu/trabajo_terminal/ros2_ur_driver/install/rrbot_description/share/rrbot_description/ros2_control/rrbot_system_with_sensor.ros2_control.xacro
/home/hunajpu/trabajo_terminal/ros2_ur_driver/install/rrbot_description/share/rrbot_description/ros2_control/rrbot_modular_actuators.ros2_control.xacro
/home/hunajpu/trabajo_terminal/ros2_ur_driver/install/rrbot_description/share/rrbot_description/ros2_control/rrbot_system_position_only.ros2_control.xacro
/home/hunajpu/trabajo_terminal/ros2_ur_driver/install/rrbot_description/share/rrbot_description/ros2_control/rrbot_system_multi_interface.ros2_control.xacro
/home/hunajpu/trabajo_terminal/ros2_ur_driver/install/rrbot_description/share/rrbot_description/urdf/rrbot_system_multi_interface.urdf.xacro
/home/hunajpu/trabajo_terminal/ros2_ur_driver/install/rrbot_description/share/rrbot_description/urdf/rrbot_modular_actuators.urdf.xacro
/home/hunajpu/trabajo_terminal/ros2_ur_driver/install/rrbot_description/share/rrbot_description/urdf/rrbot_system_with_sensor.urdf.xacro
/home/hunajpu/trabajo_terminal/ros2_ur_driver/install/rrbot_description/share/rrbot_description/urdf/rrbot_system_with_external_sensor.urdf.xacro
/home/hunajpu/trabajo_terminal/ros2_ur_driver/install/rrbot_description/share/rrbot_description/urdf/rrbot.urdf.xacro
/home/hunajpu/trabajo_terminal/ros2_ur_driver/install/rrbot_description/share/rrbot_description/urdf/rrbot_system_position_only.urdf.xacro
/home/hunajpu/trabajo_terminal/ros2_ur_driver/install/rrbot_description/share/rrbot_description/urdf/rrbot_description.urdf.xacro
/home/hunajpu/trabajo_terminal/ros2_ur_driver/install/rrbot_description/share/rrbot_description/environment/rrbot_description.dsv
/home/hunajpu/trabajo_terminal/ros2_ur_driver/install/rrbot_description/share/ament_index/resource_index/package_run_dependencies/rrbot_description
/home/hunajpu/trabajo_terminal/ros2_ur_driver/install/rrbot_description/share/ament_index/resource_index/parent_prefix_path/rrbot_description
/home/hunajpu/trabajo_terminal/ros2_ur_driver/install/rrbot_description/share/rrbot_description/environment/ament_prefix_path.sh
/home/hunajpu/trabajo_terminal/ros2_ur_driver/install/rrbot_description/share/rrbot_description/environment/ament_prefix_path.dsv
/home/hunajpu/trabajo_terminal/ros2_ur_driver/install/rrbot_description/share/rrbot_description/environment/path.sh
/home/hunajpu/trabajo_terminal/ros2_ur_driver/install/rrbot_description/share/rrbot_description/environment/path.dsv
/home/hunajpu/trabajo_terminal/ros2_ur_driver/install/rrbot_description/share/rrbot_description/local_setup.bash
/home/hunajpu/trabajo_terminal/ros2_ur_driver/install/rrbot_description/share/rrbot_description/local_setup.sh
/home/hunajpu/trabajo_terminal/ros2_ur_driver/install/rrbot_description/share/rrbot_description/local_setup.zsh
/home/hunajpu/trabajo_terminal/ros2_ur_driver/install/rrbot_description/share/rrbot_description/local_setup.dsv
/home/hunajpu/trabajo_terminal/ros2_ur_driver/install/rrbot_description/share/rrbot_description/package.dsv
/home/hunajpu/trabajo_terminal/ros2_ur_driver/install/rrbot_description/share/ament_index/resource_index/packages/rrbot_description
/home/hunajpu/trabajo_terminal/ros2_ur_driver/install/rrbot_description/share/rrbot_description/cmake/rrbot_descriptionConfig.cmake
/home/hunajpu/trabajo_terminal/ros2_ur_driver/install/rrbot_description/share/rrbot_description/cmake/rrbot_descriptionConfig-version.cmake
/home/hunajpu/trabajo_terminal/ros2_ur_driver/install/rrbot_description/share/rrbot_description/package.xml
