Hunajpu/trabajo_terminal/ros2_ur_driver/build/ur_description/install_manifest.txt

/home/hunajpu/trabajo_terminal/ros2_ur_driver/install/ur_description/share/ur_description/config/ur10e/visual_parameters.yaml
/home/hunajpu/trabajo_terminal/ros2_ur_driver/install/ur_description/share/ur_description/config/ur10e/default_kinematics.yaml
/home/hunajpu/trabajo_terminal/ros2_ur_driver/install/ur_description/share/ur_description/config/ur10e/physical_parameters.yaml
/home/hunajpu/trabajo_terminal/ros2_ur_driver/install/ur_description/share/ur_description/config/ur10e/joint_limits.yaml
/home/hunajpu/trabajo_terminal/ros2_ur_driver/install/ur_description/share/ur_description/config/ur10/visual_parameters.yaml
/home/hunajpu/trabajo_terminal/ros2_ur_driver/install/ur_description/share/ur_description/config/ur10/default_kinematics.yaml
/home/hunajpu/trabajo_terminal/ros2_ur_driver/install/ur_description/share/ur_description/config/ur10/physical_parameters.yaml
/home/hunajpu/trabajo_terminal/ros2_ur_driver/install/ur_description/share/ur_description/config/ur10/joint_limits.yaml
/home/hunajpu/trabajo_terminal/ros2_ur_driver/install/ur_description/share/ur_description/config/ur5/visual_parameters.yaml
/home/hunajpu/trabajo_terminal/ros2_ur_driver/install/ur_description/share/ur_description/config/ur5/default_kinematics.yaml
/home/hunajpu/trabajo_terminal/ros2_ur_driver/install/ur_description/share/ur_description/config/ur5/physical_parameters.yaml
/home/hunajpu/trabajo_terminal/ros2_ur_driver/install/ur_description/share/ur_description/config/ur5/joint_limits.yaml
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
/home/hunajpu/trabajo_terminal/ros2_ur_driver/install/ur_description/share/ur_description/rviz/view_robot.rviz
/home/hunajpu/trabajo_terminal/ros2_ur_driver/install/ur_description/share/ur_description/urdf/ur.ros2_control.xacro
/home/hunajpu/trabajo_terminal/ros2_ur_driver/install/ur_description/share/ur_description/urdf/inc/ur_common.xacro
/home/hunajpu/trabajo_terminal/ros2_ur_driver/install/ur_description/share/ur_description/urdf/inc/ur_transmissions.xacro
/home/hunajpu/trabajo_terminal/ros2_ur_driver/install/ur_description/share/ur_description/urdf/ur_macro.xacro
/home/hunajpu/trabajo_terminal/ros2_ur_driver/install/ur_description/share/ur_description/urdf/ur.urdf.xacro
/home/hunajpu/trabajo_terminal/ros2_ur_driver/install/ur_description/share/ur_description/test/test_view_ur_launch.py
/home/hunajpu/trabajo_terminal/ros2_ur_driver/install/ur_description/share/ur_description/test/test_ur_urdf_xacro.py
/home/hunajpu/trabajo_terminal/ros2_ur_driver/install/ur_description/share/ament_index/resource_index/package_run_dependencies/ur_description
/home/hunajpu/trabajo_terminal/ros2_ur_driver/install/ur_description/share/ament_index/resource_index/parent_prefix_path/ur_description
/home/hunajpu/trabajo_terminal/ros2_ur_driver/install/ur_description/share/ur_description/environment/ament_prefix_path.sh
/home/hunajpu/trabajo_terminal/ros2_ur_driver/install/ur_description/share/ur_description/environment/ament_prefix_path.dsv
/home/hunajpu/trabajo_terminal/ros2_ur_driver/install/ur_description/share/ur_description/environment/path.sh
/home/hunajpu/trabajo_terminal/ros2_ur_driver/install/ur_description/share/ur_description/environment/path.dsv
/home/hunajpu/trabajo_terminal/ros2_ur_driver/install/ur_description/share/ur_description/local_setup.bash
/home/hunajpu/trabajo_terminal/ros2_ur_driver/install/ur_description/share/ur_description/local_setup.sh
/home/hunajpu/trabajo_terminal/ros2_ur_driver/install/ur_description/share/ur_description/local_setup.zsh
/home/hunajpu/trabajo_terminal/ros2_ur_driver/install/ur_description/share/ur_description/local_setup.dsv
/home/hunajpu/trabajo_terminal/ros2_ur_driver/install/ur_description/share/ur_description/package.dsv
/home/hunajpu/trabajo_terminal/ros2_ur_driver/install/ur_description/share/ament_index/resource_index/packages/ur_description
/home/hunajpu/trabajo_terminal/ros2_ur_driver/install/ur_description/share/ur_description/cmake/ur_descriptionConfig.cmake
/home/hunajpu/trabajo_terminal/ros2_ur_driver/install/ur_description/share/ur_description/cmake/ur_descriptionConfig-version.cmake
/home/hunajpu/trabajo_terminal/ros2_ur_driver/install/ur_description/share/ur_description/package.xml
