Hunajpu/trabajo_terminal/PrimerreporteparcialTrabajoTerminal/Constructor/perdidos/Principal-vacia.pdf

## INSTITUTO POLITECNICO NACIONAL ´

UNIDAD PROFESIONAL INTERDISCIPLINARIA EN

INGENIERÍA Y TECNOLOGÍAS AVANZADAS

## Trabajo Terminal II

## “SISTEMAS HÍBRIDOS”

Que para obtener el título de

## “Ingeniero en Mecatrónica”

Presentan:

## joni Karel

## iohannes Karl

## Jan Kaarle

## Giovanni Karol

Asesores:

## Dr. Jean Karolis

## Dr. Johannes Carolus

## Dr. Ivan Karurosu

JULIO 1999

## INSTITUTO POLITECNICO NACIONAL ´

UNIDAD PROFESIONAL INTERDISCIPLINARIA EN

INGENIERÍA Y TECNOLOGÍAS AVANZADAS

## Trabajo Terminal II

## “SISTEMAS HÍBRIDOS”

Que para obtener el título de

## “Ingeniero en Mecatrónica”

Presentan:

joni Karel | iohannes Karl
Jan Kaarle | Giovanni Karol

Asesores:

Dr. Jean Karolis | Dr. Johannes Carolus

Dr. Ivan Karurosu

Presidente del Jurado

Dr. Juan Carlos

Profesor titular

Dr. John Charles

# DEDICATORIA

dedico este trabajo a y aa ....

porque ...

bla bla bla bla

bla bla

# AGRADECIMIENTOS

Al CONACYT por la beca-crédito otorgada para la realización de mis estudios.

Así mismo agradezco a mis maestros, compañeros y a toda aquella persona que

de alguna manera contribuyó al término de mis estudios de maestría.

## Contenido

Nomenclatura | IX
Simbología | XI
Resumen/Abstract | XIII
Objetivos | XV
Introducción | XVII
1. Marco de referencía | 1
2. Diseño | 3

iii

CONTENIDO

[a\

3. Implementación | 5
4. Análisis de resultados | 7
5. Conclusiones | 9
Apéndices | 11
Apéndice 1 | 13
Der Zweite Anhang (Apéndice 2) | 15
Der dritte Anhang (Apéndice 3) | 17
Anexos | 19
Anexo 1. Hoja de datos | 21
Anexo 2 (Anexo2 ) | 23
Anexo 3(Anexo 3) | 25
iv | IPN | Ing. Mecatrónica

## Índice de figuras

v

## Índice de Tablas

vii

## Nomenclatura

lista de nomenclaturas

ix

## Simbología

Simbolo1

xi

## Resumen/Abstract

## ”Diseño, modelado y construcción de un robot bípedo

## de 10 grados de libertad con morfología humanoide”

Palabras Clave: Robot, Bípedo, Humanoide, Marcha humana, Criterio de equi-

librio, Punto de momento Cero, Actuadores, Sensores, Fuerza, Par torsor, Modelo

matemático, Estructura, Diseño mecánico, Esfuerzos, Desplazamientos, Optimiza-

ción, Simulaciones, Trayectoria, Cinemática directa e inversa, Análisis.

Abstract:

Resumen:

xiii

## Objetivos

## Objetivo general

Objetivos Particulares.

xv

## Introducción

## Antecedentes

## Planteamiento del problema

## Descripción de los capítulos

xvii

## Marco de referencía

1

## Diseño

## 2.1. Diseño Conceptual

### 2.1.1. Necesidades

### 2.1.2. Requerimientos

### 2.1.3. Descomposición por funciones

### 2.1.4. Conceptualización

Análisis Morfológico (opcional)

### 2.1.5. Selección Diseño Conceptual

Concepto Final

3

Diseño

[a\

## 2.2. Diseño Detallado

### 2.2.1. Diseño Area Funcional ´

### 2.2.2. Diseño Area Funcional 1 ´

### 2.2.3. Diseño Area Funcional n ´

### 2.2.4. Integración de Areas funcionales ´

## 2.3. Validación y Simulación

4 | IPN | Ing. Mecatrónica

## Implementación

## 3.1. Implementación Area Funcional ´

## 3.2. Implementación Area Funcional 1 ´

## 3.3. Implementación Area Funcional n ´

## 3.4. Integración de Areas funcionales ´

5

## Análisis de resultados

7

## Conclusiones

9

# Apéndices

11

## Apéndice 1

Incluyen información que ayuda a interpretar parte del contenido del libro, o as-

pectos más técnicos y menos esenciales del libro, como información complementaria.

Ab hier beginnt der backmatter.

13

## Der Zweite Anhang (Apéndice 2)

Das Appendix (Anhang) Fragment wird einmal an der gewünschten Position

im Dokument eingefügt. Weitere Anhänge können dann mittels der Zuweisung von

Abschnitten (sections) erzeugt werden.

Ab hier beginnt der backmatter.

15

## Der dritte Anhang (Apéndice 3)

Das Appendix (Anhang) Fragment wird einmal an der gewünschten Position

im Dokument eingefügt. Weitere Anhänge können dann mittels der Zuweisung von

Abschnitten (sections) erzeugt werden.

Ab hier beginnt der backmatter.

17

# Anexos

19

## Anexo 1. Hoja de datos

Una ficha técnica, hoja técnica u hoja de datos (datasheet en inglés), también

ficha de características u hoja de características, es un documento que resume el fun-

cionamiento y otras características de un componente (por ejemplo, un componente

electrónico) o subsistema (por ejemplo, una fuente de alimentación) con el suficiente

detalle para ser utilizado por un ingeniero de diseño y diseñar el componente en un

sistema.

Comienza típicamente con una página introductoria que describe el resto del

documento, seguido por los listados de componentes específicos, con la información

adicional sobre la conectividad de los dispositivos. En caso de que haya código fuente

relevante a incluir, se une cerca del extremo del documento o se separa generalmente

en otro archivo.

Las fichas técnicas no se limitan solo a componentes electrónicos, si no que tam-

bién se dan en otros campos de la ciencia, como por ejemplo compuestos químicos o

alimentos.

Ab hier beginnt der backmatter.

21

## Anexo 2 (Anexo2 )

Das Appendix (Anhang) Fragment wird einmal an der gewünschten Position

im Dokument eingefügt. Weitere Anhänge können dann mittels der Zuweisung von

Abschnitten (sections) erzeugt werden.

Ab hier beginnt der backmatter.

23

## Anexo 3(Anexo 3)

Das Appendix (Anhang) Fragment wird einmal an der gewünschten Position

im Dokument eingefügt. Weitere Anhänge können dann mittels der Zuweisung von

Abschnitten (sections) erzeugt werden.

Ab hier beginnt der backmatter.

25
