Hunajpu/trabajo_terminal/(commit log)

2022-03-05 simulacion de robot ur3
2022-03-16 Add simulations and start 3d model
    [Aluminium30x30.SLDPRT, Caracteristicas_fisicas_robots.ods, Ensamble.FCStd, GPA15GT2090-A-H4.stp, HFS8-4040-400.stp, MGN12 Rail 500mm.SLDPRT, MGN12 Rail 500mm.step, MGN12C.SLDPRT]
2022-05-12 Modelado en FreeCAD del sistema
    [AxisBase.FCStd, Belt_Clamp.FCStd, Correa.FCStd, EjeLineal.FCStd, EncoderSupport.FCStd, EncoderSupport2.FCStd, Ensamble.FCStd, GearboxSupport.FCStd]
2022-05-12 Piezas utiles para el modelado
    [Aluminium30x30.SLDPRT, Aluminium30x30.step, SR M4 bolt nut assy.SLDPRT, TBCK-XL025.stp, deleteThisFile.FCStd]
2022-05-12 Archivos de datos excel
    [Antecedentes.xlsx, Objetivos_ponderados_propuestas.xlsx]
2022-05-12 Ensanmbles de FreeCAD
    [Carro.FCStd, Polea.FCStd]
2022-05-12 Otros archivos importantes
    [Caracteristicas_fisicas_robots.ods, Objetivos_ponderados_propuestas.ods]
