Hunajpu/trabajo_terminal/(notices)

Notices in the files:
Piezas/guia_lineal_set/SX2RZ28-520.stp:
FILE_NAME( 'p:/temp/worker_1/temp/exporttempdir_436_502_WNVQQ/format_0/SX2RZ28-520.stp', '2022-03-14T04:48:14', ( 'License CC BY-ND 4.0' ), ( 'CADENAS' ), ' ', 'PARTsolutions', ' ' );
Piezas/polea/GPA15GT2090-A-H4.stp:
FILE_NAME( 'p:/temp/worker_1/temp/exporttempdir_436_404_1ynDo/format_0/GPA15GT2090-A-H4.stp', '2022-03-14T00:47:50', ( 'License CC BY-ND 4.0' ), ( 'CADENAS' ), ' ', 'PARTsolutions', ' ' );
Piezas/guia_lineal/SRZL28-520.stp:
FILE_NAME( 'p:/temp/worker_1/temp/exporttempdir_436_496_arHg7/format_0/SRZL28-520.stp', '2022-03-14T04:43:29', ( 'License CC BY-ND 4.0' ), ( 'CADENAS' ), ' ', 'PARTsolutions', ' ' );
Piezas/perfil aluminio 400/HFS8-4040-400.stp:
FILE_NAME( 'p:/temp/worker_3/temp/exporttempdir_4832_499_YvLzu/format_0/HFS8-4040-400.stp', '2022-03-14T04:52:34', ( 'License CC BY-ND 4.0' ), ( 'CADENAS' ), ' ', 'PARTsolutions', ' ' );
Piezas/belt_clamp/TBCK-XL025.stp:
FILE_NAME( 'p:/temp/worker_2/temp/exporttempdir_3604_900_aSmcP/format_0/TBCK-XL025.stp', '2022-03-24T01:35:42', ( 'License CC BY-ND 4.0' ), ( 'CADENAS' ), ' ', 'PARTsolutions', ' ' );
